saurabhparulekar24/HelMate/A02G_schematics-i/README.md

Review Assignment Due Date (https://classroom.github.com/a/yeGjPO4S)
# a02g-schematics-i

    * Team Number: 26
    * Team Name: Circuit Crusaders
    * Team Members: Binh Nguyen, Saurabh Parulekar
    * Description of hardware:
      1. HP Pavilion Windows Gaming laptop, 15" 8GB i5
      2. Apple M2 Pro - Macbook
    * Github Repository URL: https://github.com/ese5160/a02g-schematics-i-t26-circuit-crusaders

## 1 Component Creation
Component Location Updated BOM: [Circuit Crusaders BOM](https://github.com/ese5160/a02g-schematics-i-t26-circuit-crusaders/blob/main/A01G%20bom%20-%20Circuit%20Crusders.xlsx)

## 2 Schematic Capture
Altium Project Files: [Circuit Crusaders Project](https://upenn-eselabs.365.altium.com/designs/114505C5-8A92-40C3-9C26-AFBB1F629568)

## Github Repo Submission Resources

* [ESE5160 Example Repo Submission](https://github.com/ese5160/example-repository-submission)
* [Markdown Guide: Basic Syntax](https://www.markdownguide.org/basic-syntax/)
* [Adobe free video to gif converter](https://www.adobe.com/express/feature/video/convert/video-to-gif)
* [Curated list of example READMEs](https://github.com/matiassingers/awesome-readme)
* [VS Code](https://code.visualstudio.com/) is heavily recommended to develop code and handle Git commits
  * Code formatting and extension recommendation files come with this repository.
  * Ctrl+Shift+V will render the README.md (maybe not the images though)
