saurabhparulekar24/HelMate/A03G_schematics-ii/README.md

Review Assignment Due Date (https://classroom.github.com/a/Ba1hqn3X)
# a03g-schematics-ii

    * Team Number: 26
    * Team Name: Circuit Crusaders
    * Team Members: Saurabh Sandeep Parulekar, Binh Nguyen
    * Description of hardware: 
      1. HP Pavilion Windows Gaming laptop, 15" 8GB i5
      2. Apple M2 Pro - Macbook 
    * Github Repository URL: https://github.com/ese5160/a03g-schematics-ii-t26-circuit-crusaders

## 1 PCBA Bill of Materials (Altium)
[PCB Bill of Materials](https://upenn-eselabs.365.altium.com/designs/114505C5-8A92-40C3-9C26-AFBB1F629568#design)
## 2 Non PCBA Bill of Materials (Excel)
[Non PCB BOM](https://github.com/ese5160/a03g-schematics-ii-t26-circuit-crusaders/blob/main/A03G%20non%20pcba%20bom%20-%20Circuit%20Crusaders.xlsx)

## 3 Updated Schematic Capture
[Update Schematic Capture](https://upenn-eselabs.365.altium.com/designs/114505C5-8A92-40C3-9C26-AFBB1F629568#design)

## Github Repo Submission Resources

* [ESE5160 Example Repo Submission](https://github.com/ese5160/example-repository-submission)
* [Markdown Guide: Basic Syntax](https://www.markdownguide.org/basic-syntax/)
* [Adobe free video to gif converter](https://www.adobe.com/express/feature/video/convert/video-to-gif)
* [Curated list of example READMEs](https://github.com/matiassingers/awesome-readme)
* [VS Code](https://code.visualstudio.com/) is heavily recommended to develop code and handle Git commits
  * Code formatting and extension recommendation files come with this repository.
  * Ctrl+Shift+V will render the README.md (maybe not the images though)
