saurabhparulekar24/HelMate/A05G_release/README.md

Review Assignment Due Date (https://classroom.github.com/a/8iX7Ein-)
# a05g-release

    * Team Number: 26
    * Team Name: Circuit Crusaders
    * Team Members: Saurabh Parulekar, Binh Nguyen
    * Description of hardware: (embedded hardware, laptop, etc):
       + 1. HP Pavilion Windows Gaming laptop, 15" 8GB i5
       + 2. Apple M2 Pro - Macbook  
    * Github Repository URL: https://github.com/ese5160/a05g-release-t26-circuit-crusaders

## 1 PCB Finishing Touches
[Project Link](https://upenn-eselabs.365.altium.com/designs/114505C5-8A92-40C3-9C26-AFBB1F629568#design)

## 2 PCB Documentation
[Project Link](https://upenn-eselabs.365.altium.com/designs/114505C5-8A92-40C3-9C26-AFBB1F629568#design)

## 3 PCB Manufacturing Release
[Project Link](https://upenn-eselabs.365.altium.com/designs/114505C5-8A92-40C3-9C26-AFBB1F629568#design)

## 4 3D Printed PCBA
Proof that we submitted 3D printing

## Github Repo Submission Resources

* [ESE5160 Example Repo Submission](https://github.com/ese5160/example-repository-submission)
* [Markdown Guide: Basic Syntax](https://www.markdownguide.org/basic-syntax/)
* [Adobe free video to gif converter](https://www.adobe.com/express/feature/video/convert/video-to-gif)
* [Curated list of example READMEs](https://github.com/matiassingers/awesome-readme)
* [VS Code](https://code.visualstudio.com/) is heavily recommended to develop code and handle Git commits
  * Code formatting and extension recommendation files come with this repository.
  * Ctrl+Shift+V will render the README.md (maybe not the images though)
