saurabhparulekar24/HelMate/A00G_devices-designs-diagrams/Design/Block_Diagrams/detailed_block_diagram.png

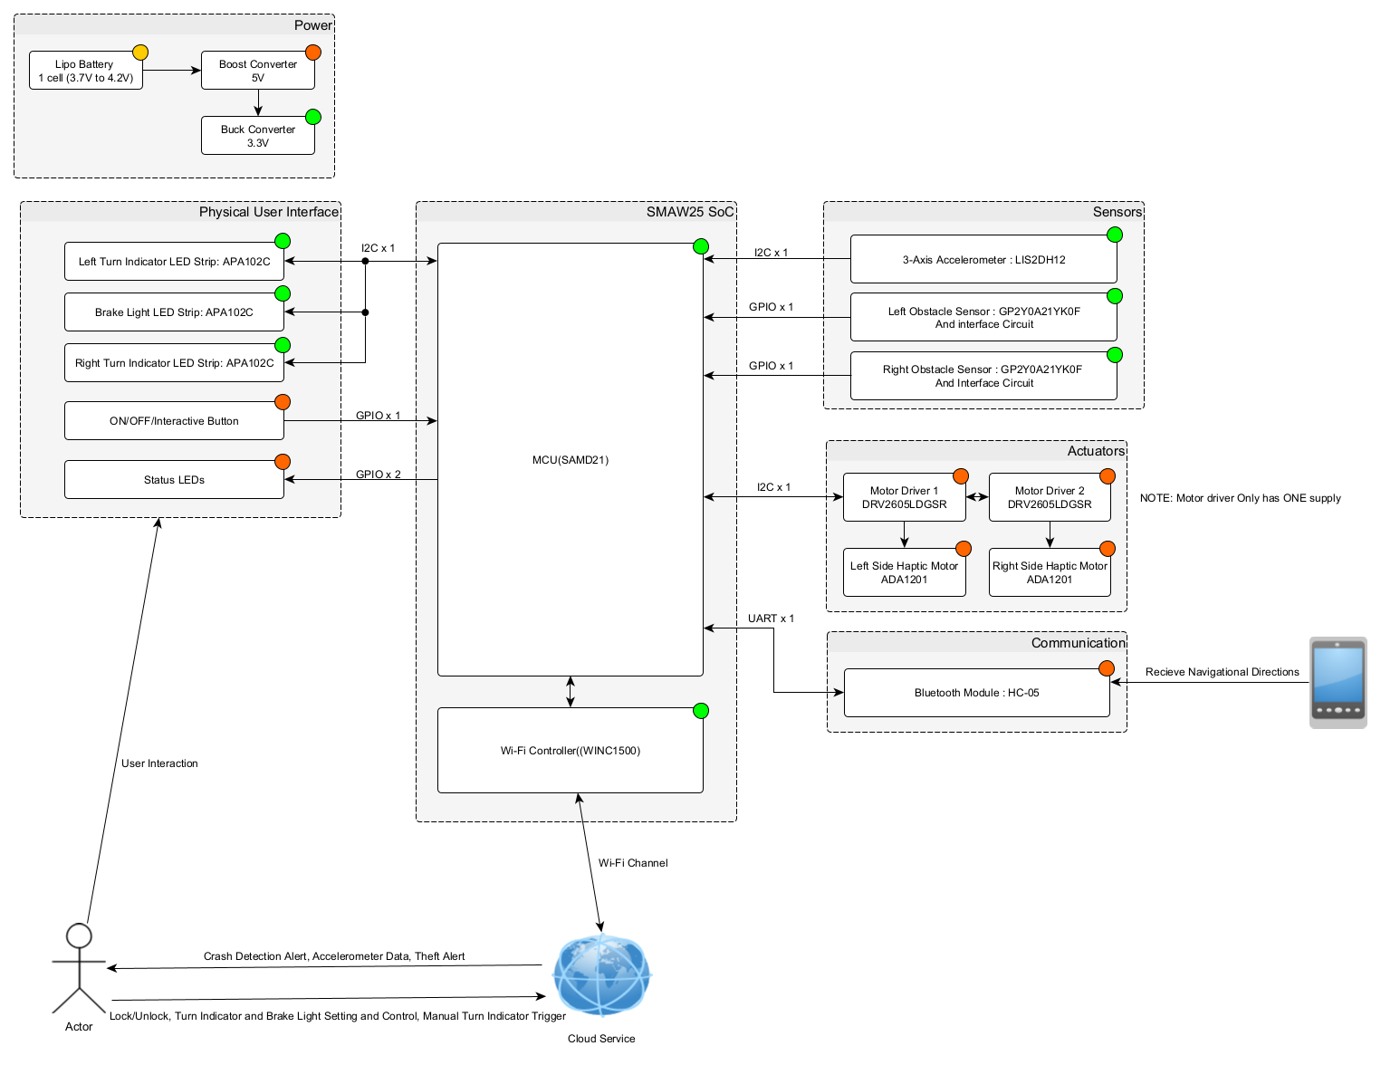
A00G_devices-designs-diagrams/Design/Block_Diagrams/detailed_block_diagram.png
