saurabhparulekar24/HelMate/A01G_components-pins-power/images/power_architecture.png

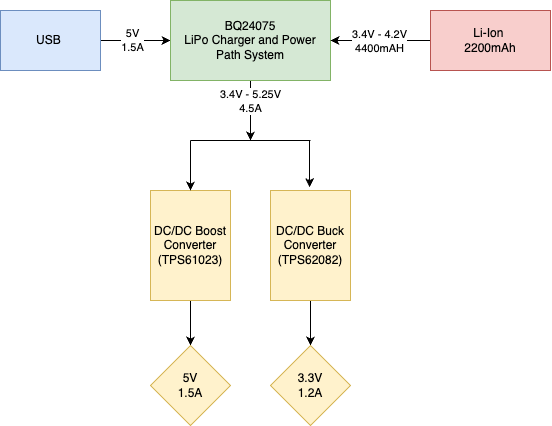
A01G_components-pins-power/images/power_architecture.png
