saurabhparulekar24/HelMate/A01G_components-pins-power/images/power_requirements.jpeg

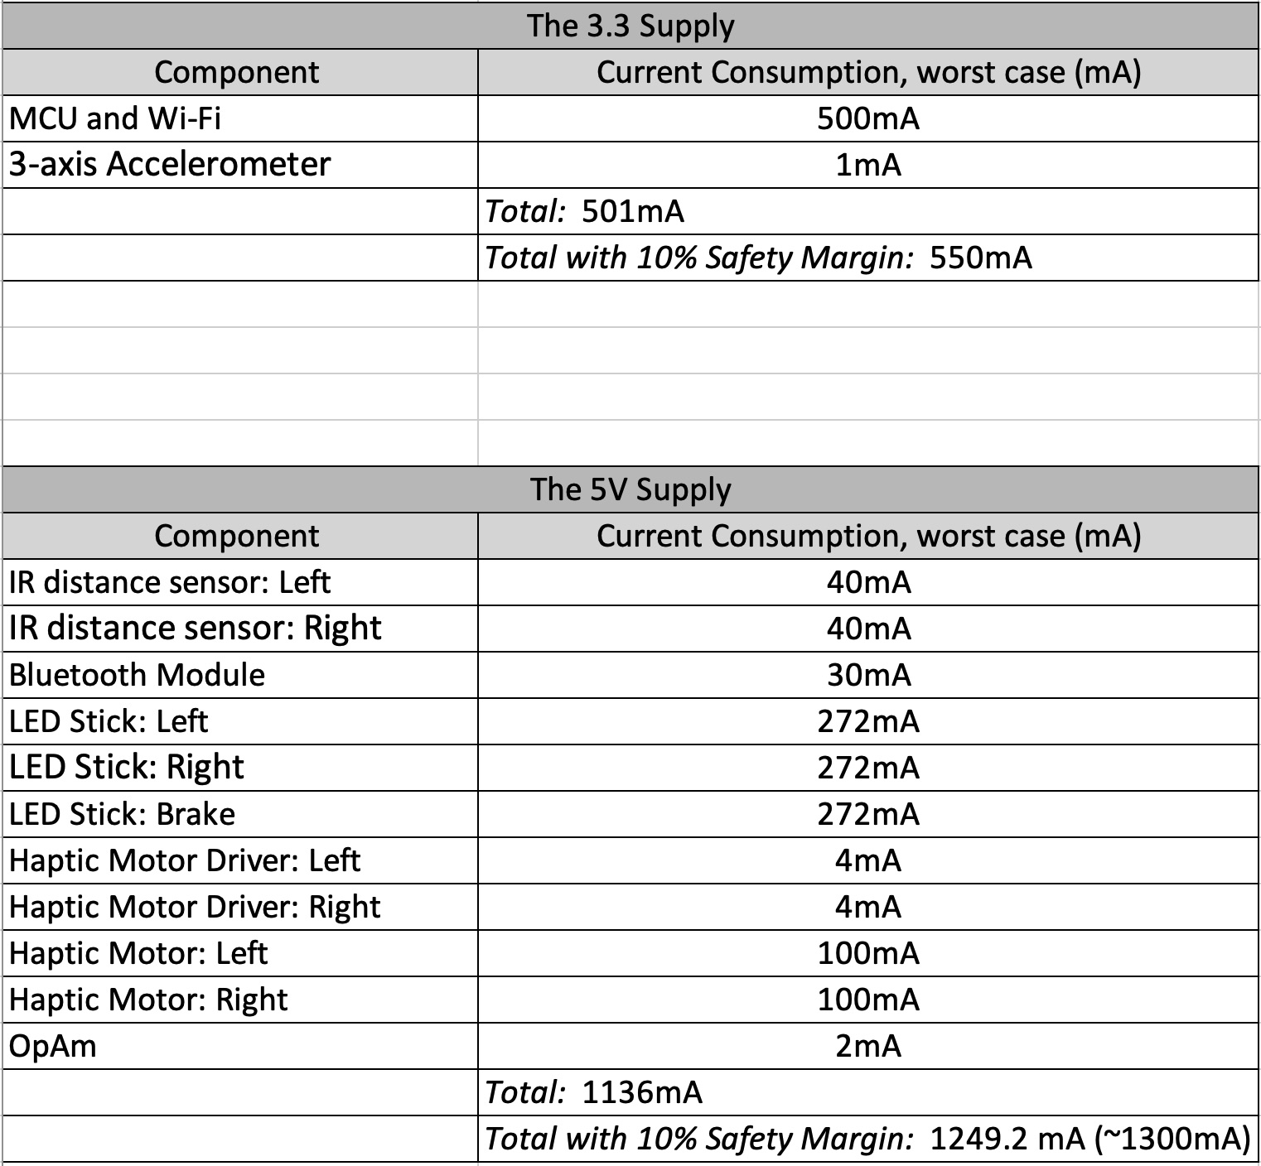
A01G_components-pins-power/images/power_requirements.jpeg
