saurabhparulekar24/HelMate/A04G_layout/image/trace_width.png

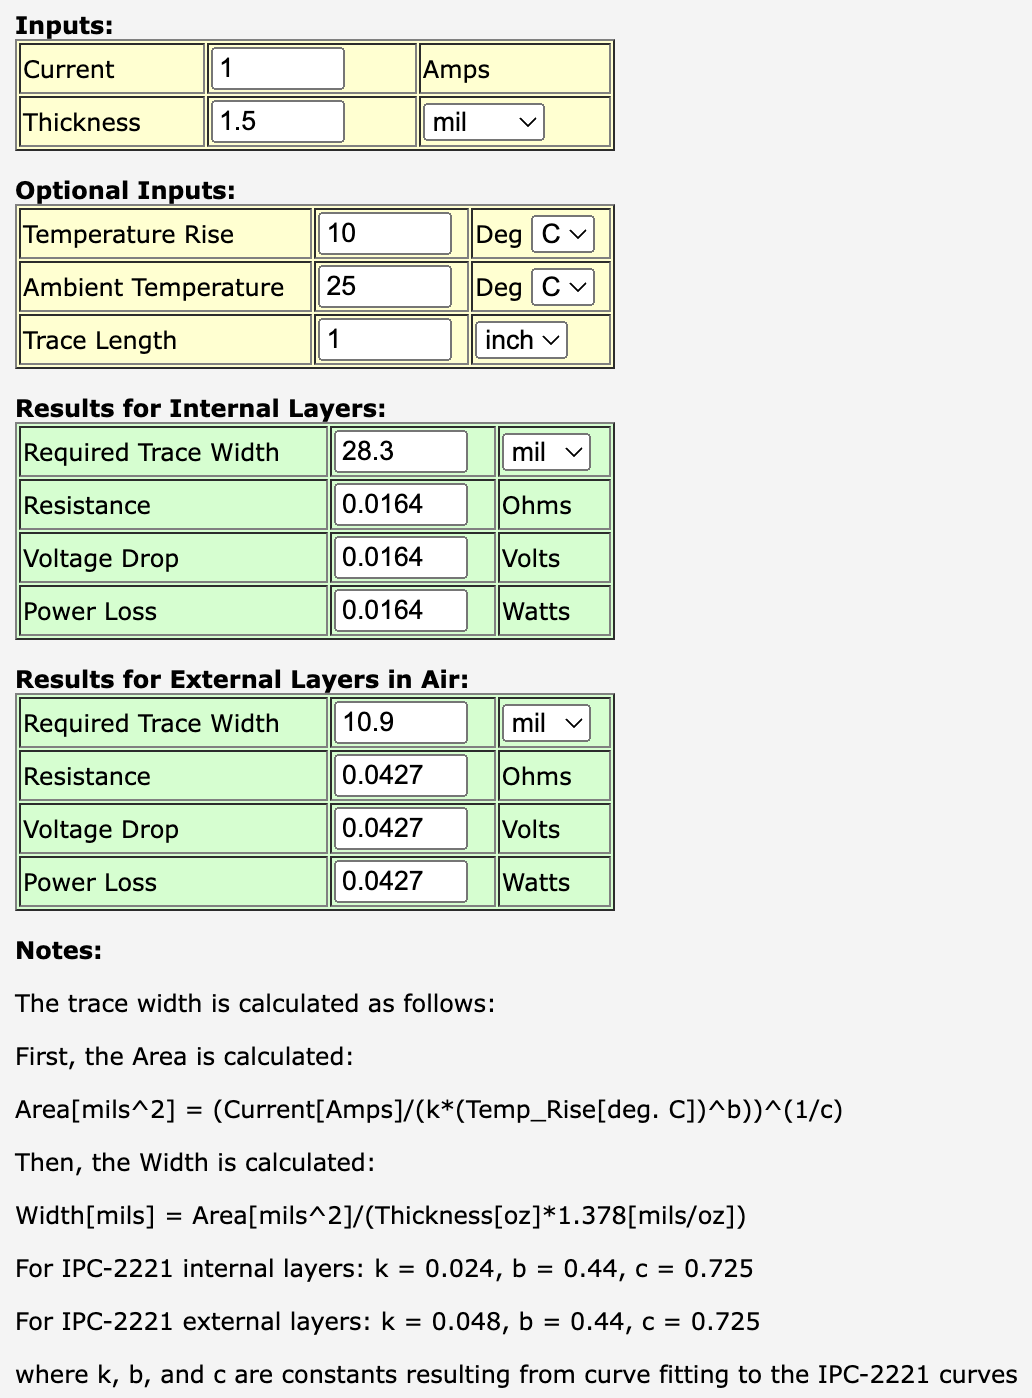
A04G_layout/image/trace_width.png
