saurabhparulekar24/HelMate/A05G_release/image/Email.jpeg

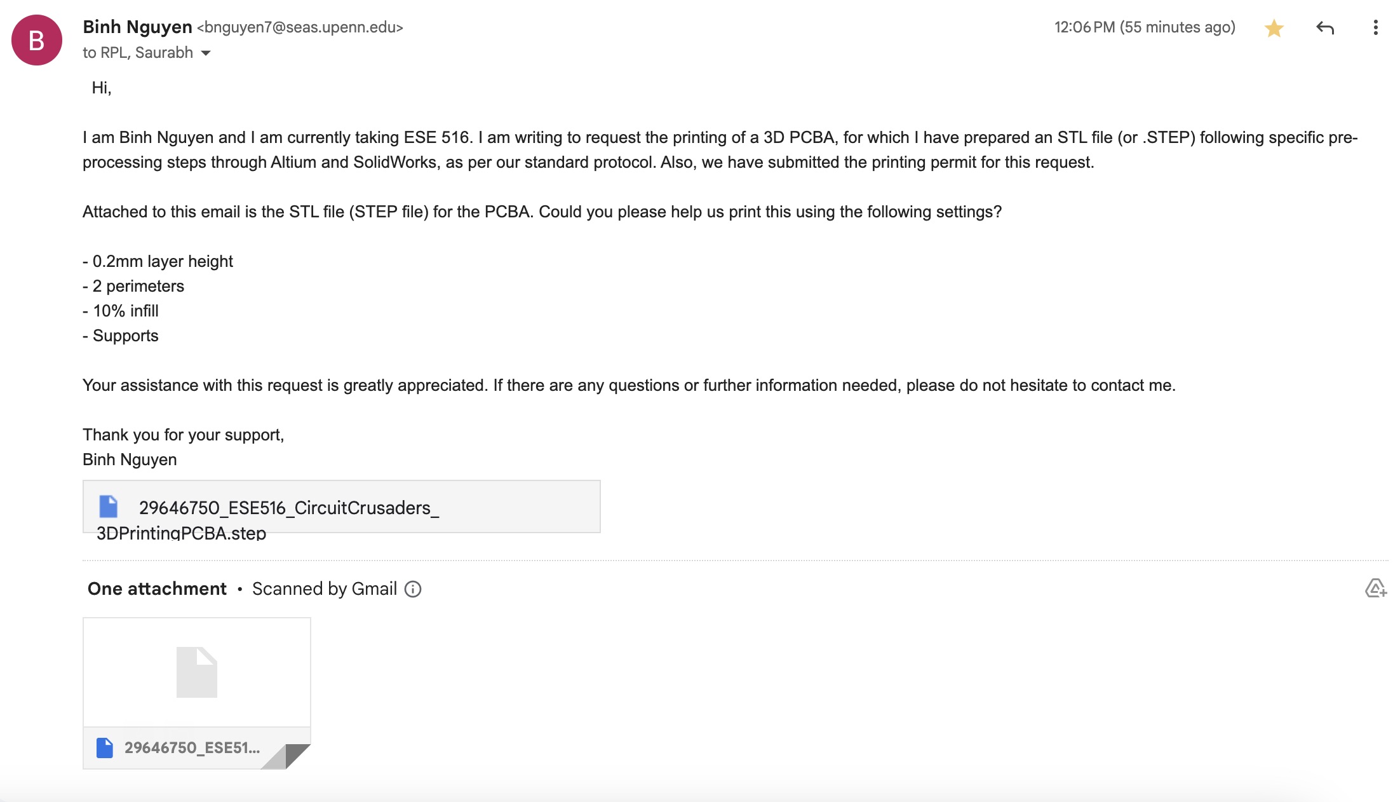
A05G_release/image/Email.jpeg
