saurabhparulekar24/HelMate/A05G_release/image/Form.jpeg

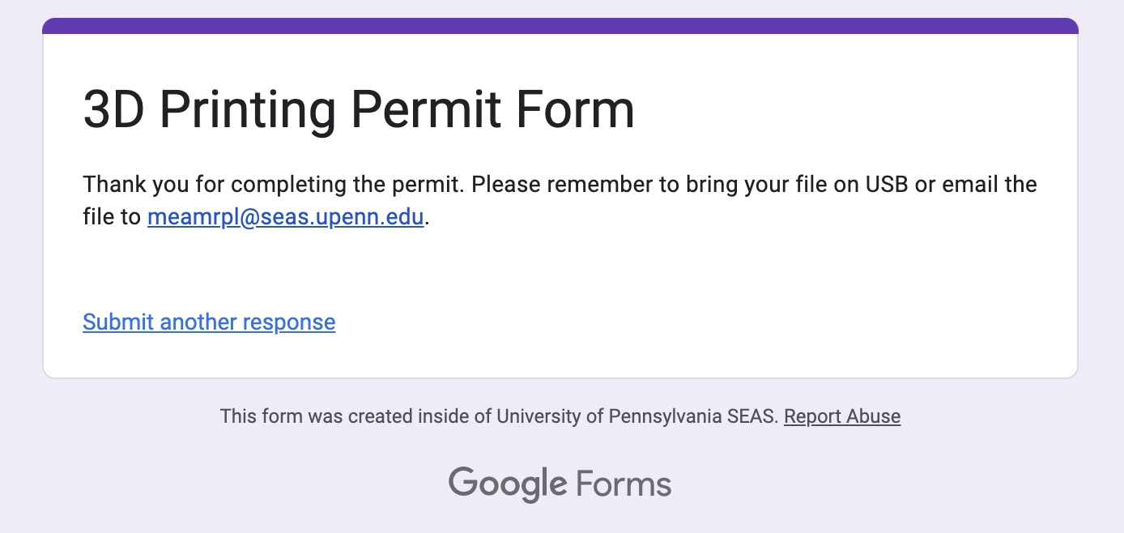
A05G_release/image/Form.jpeg
