saurabhparulekar24/HelMate/A06P_freertos-i2c/images/LED_End_Stack.png

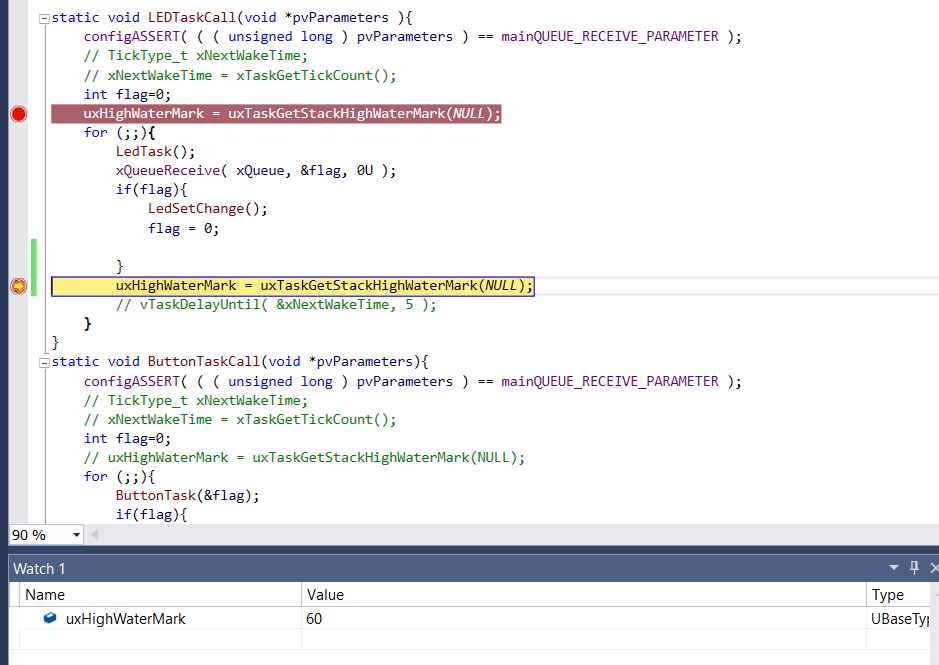
A06P_freertos-i2c/images/LED_End_Stack.png
