saurabhparulekar24/HelMate/A06P_freertos-i2c/images/LED_Start_Stack.png

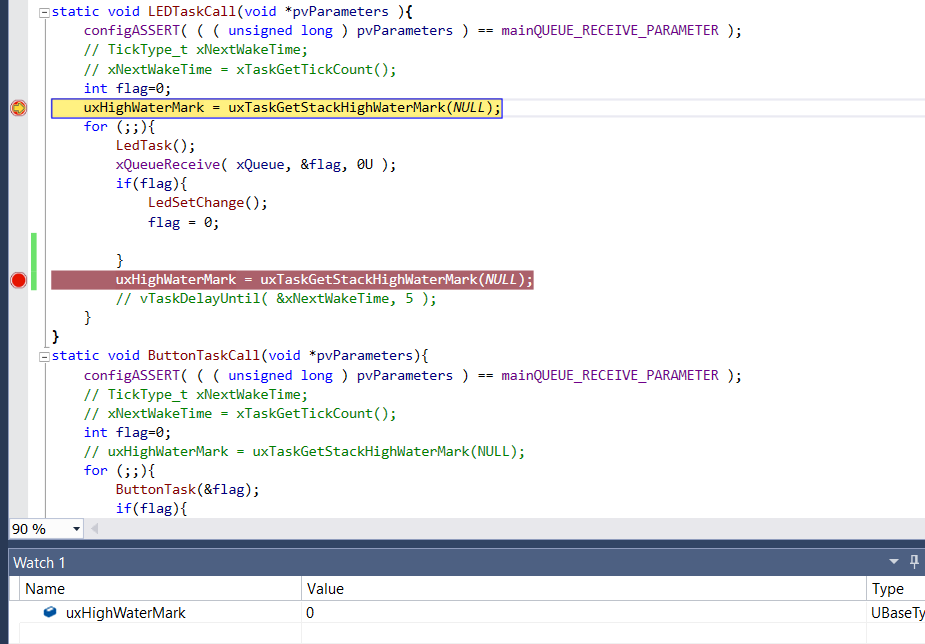
A06P_freertos-i2c/images/LED_Start_Stack.png
