saurabhparulekar24/HelMate/A06P_freertos-i2c/images/WINC1500Update.png

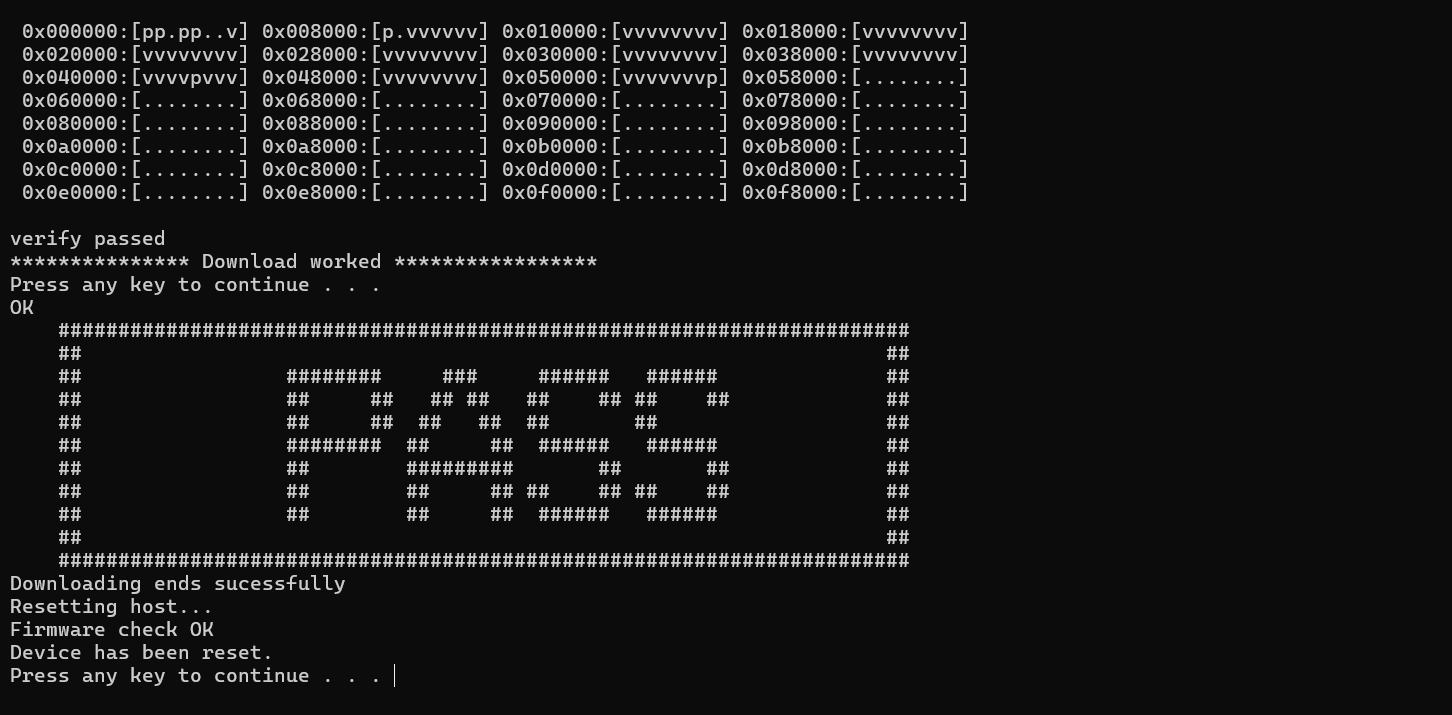
A06P_freertos-i2c/images/WINC1500Update.png
