saurabhparulekar24/HelMate/A07G_exploring-the-cli/Images and Captures/COM11  (EDBG Virtual COM Port (COM11)) 2024-03-20 13-27-54.gif

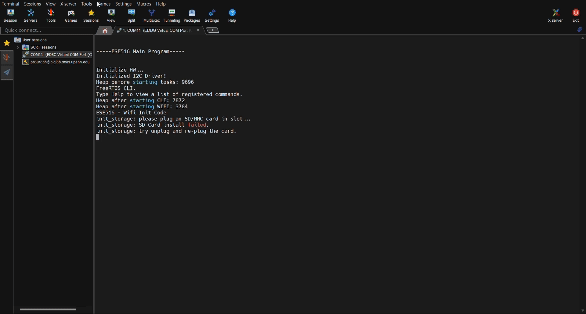
A07G_exploring-the-cli/Images and Captures/COM11 (EDBG Virtual COM Port (COM11)) 2024-03-20 13-27-54.gif
