saurabhparulekar24/HelMate/A07G_exploring-the-cli/Images and Captures/percipio.png

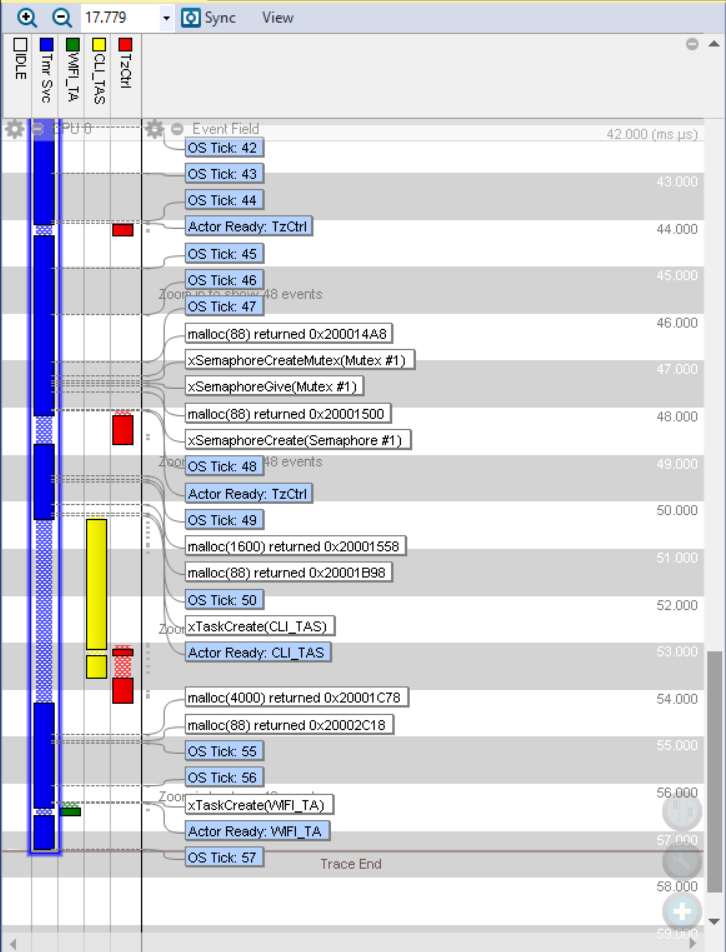
A07G_exploring-the-cli/Images and Captures/percipio.png
