saurabhparulekar24/HelMate/A07G_exploring-the-cli/Images and Captures/Q7.jpg

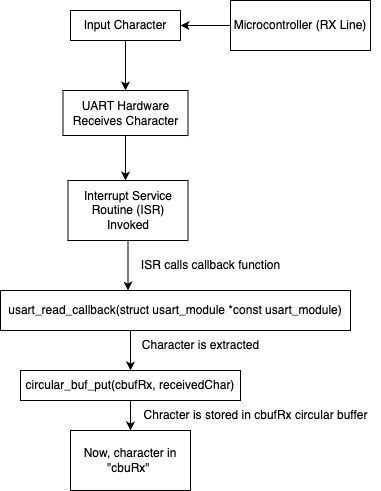
A07G_exploring-the-cli/Images and Captures/Q7.jpg
