saurabhparulekar24/HelMate/A07G_exploring-the-cli/Images and Captures/Q8.jpg

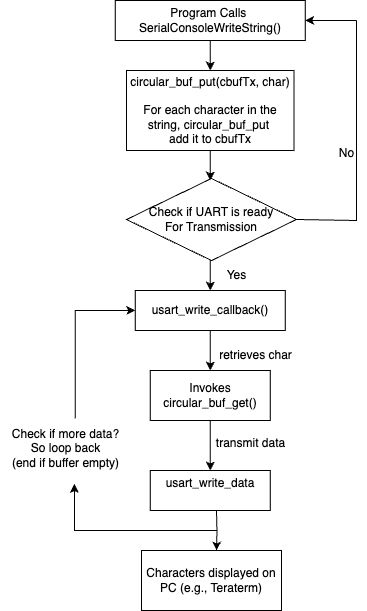
A07G_exploring-the-cli/Images and Captures/Q8.jpg
