saurabhparulekar24/HelMate/A07G_exploring-the-cli/Images and Captures/ResetfromCLI.png

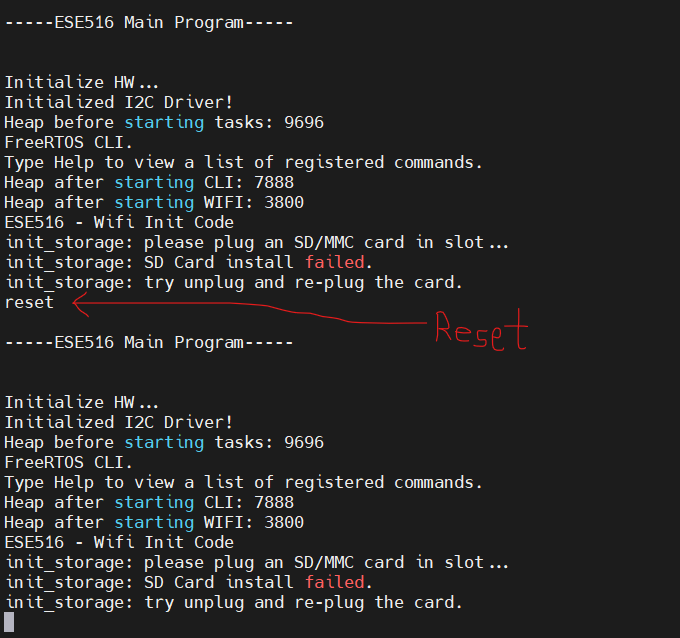
A07G_exploring-the-cli/Images and Captures/ResetfromCLI.png
