saurabhparulekar24/HelMate/A07G_exploring-the-cli/Images and Captures/USART_Pins.png

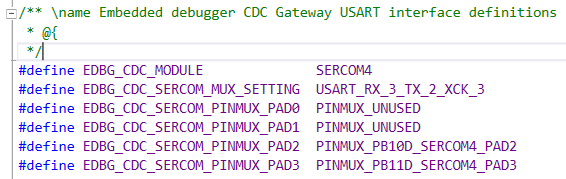
A07G_exploring-the-cli/Images and Captures/USART_Pins.png
