saurabhparulekar24/HelMate/A08G_comm-protocols/Images and Captures/Daisychain.drawio.png

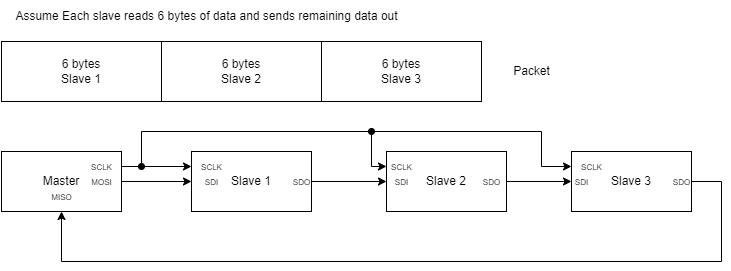
A08G_comm-protocols/Images and Captures/Daisychain.drawio.png
