saurabhparulekar24/HelMate/A08G_comm-protocols/Images and Captures/I2C_data.png

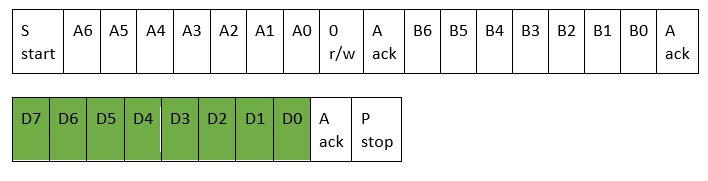
A08G_comm-protocols/Images and Captures/I2C_data.png
