saurabhparulekar24/HelMate/A08G_comm-protocols/Images and Captures/IMU_SS.png

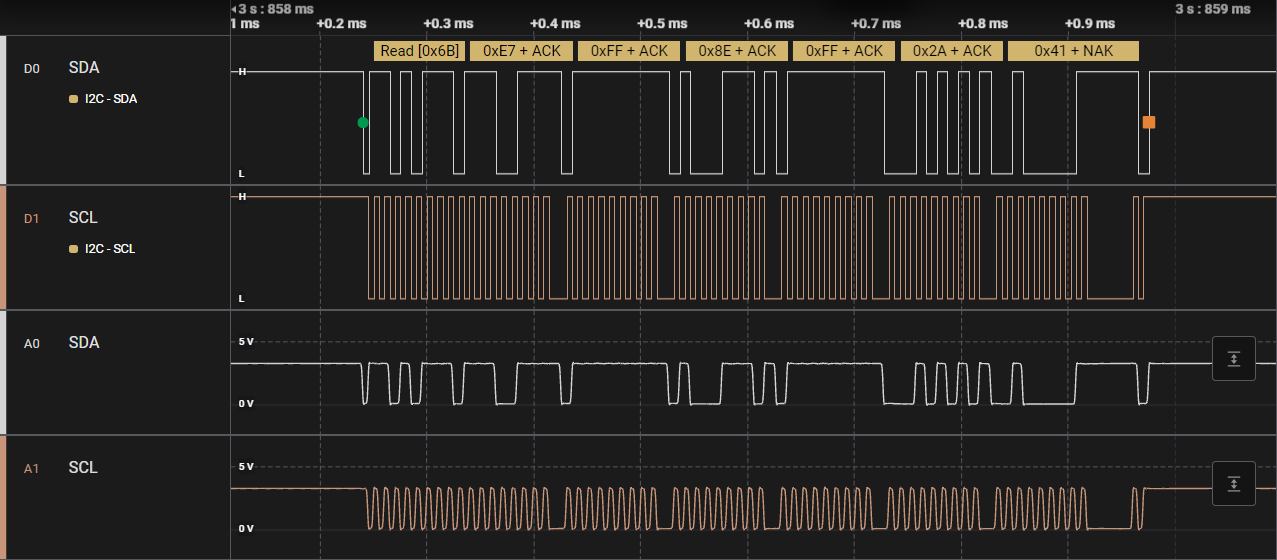
A08G_comm-protocols/Images and Captures/IMU_SS.png
