saurabhparulekar24/HelMate/A08G_comm-protocols/Images and Captures/SPI_S_to_V.png

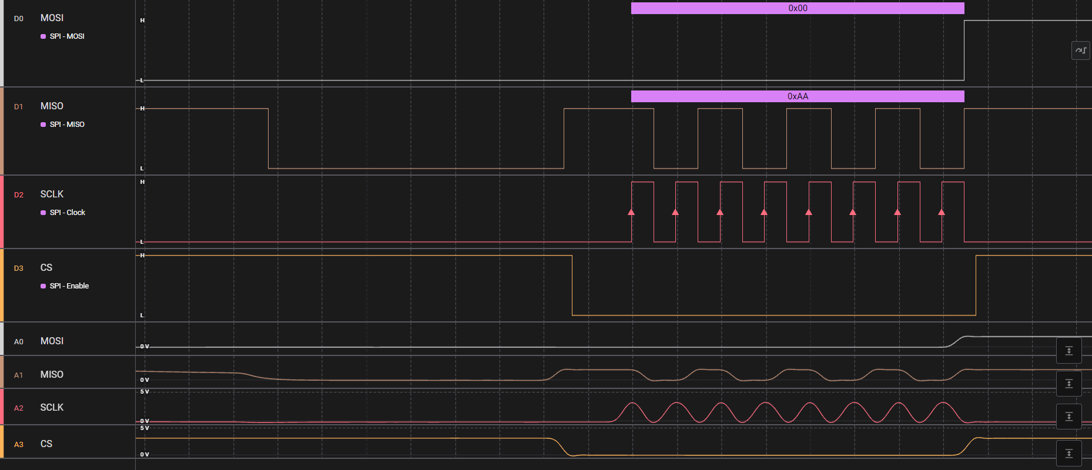
A08G_comm-protocols/Images and Captures/SPI_S_to_V.png
