saurabhparulekar24/HelMate/A08G_comm-protocols/Images and Captures/UART_V_to_S.png

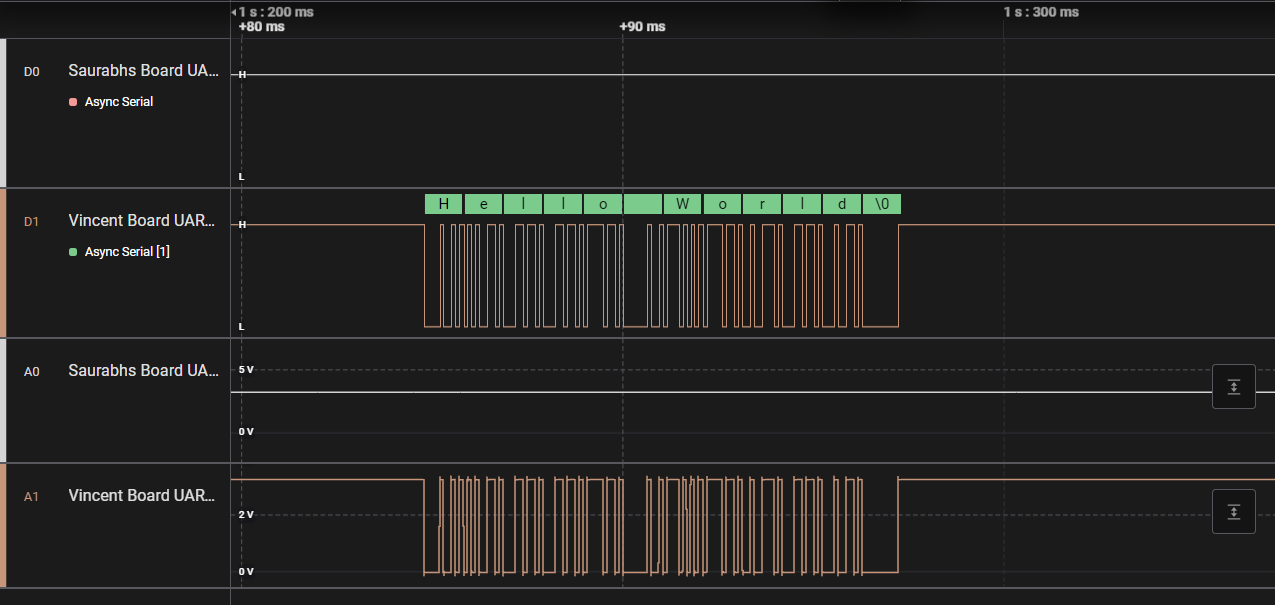
A08G_comm-protocols/Images and Captures/UART_V_to_S.png
