saurabhparulekar24/HelMate/A09G_the-bootloader-waltz/images and Captures/BlockDiagramI2C.drawio (1).png

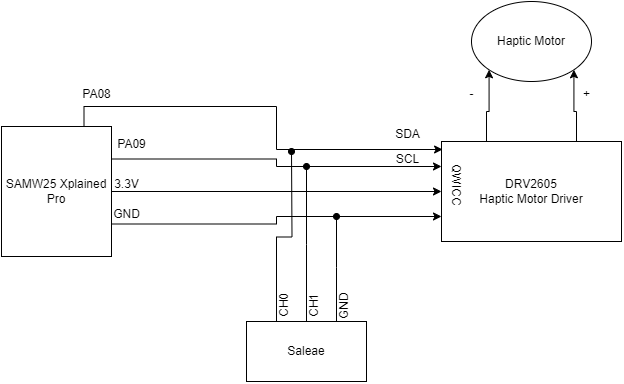
A09G_the-bootloader-waltz/images and Captures/BlockDiagramI2C.drawio (1).png
