saurabhparulekar24/HelMate/A09G_the-bootloader-waltz/images and Captures/BootLoader_FlowChart.png

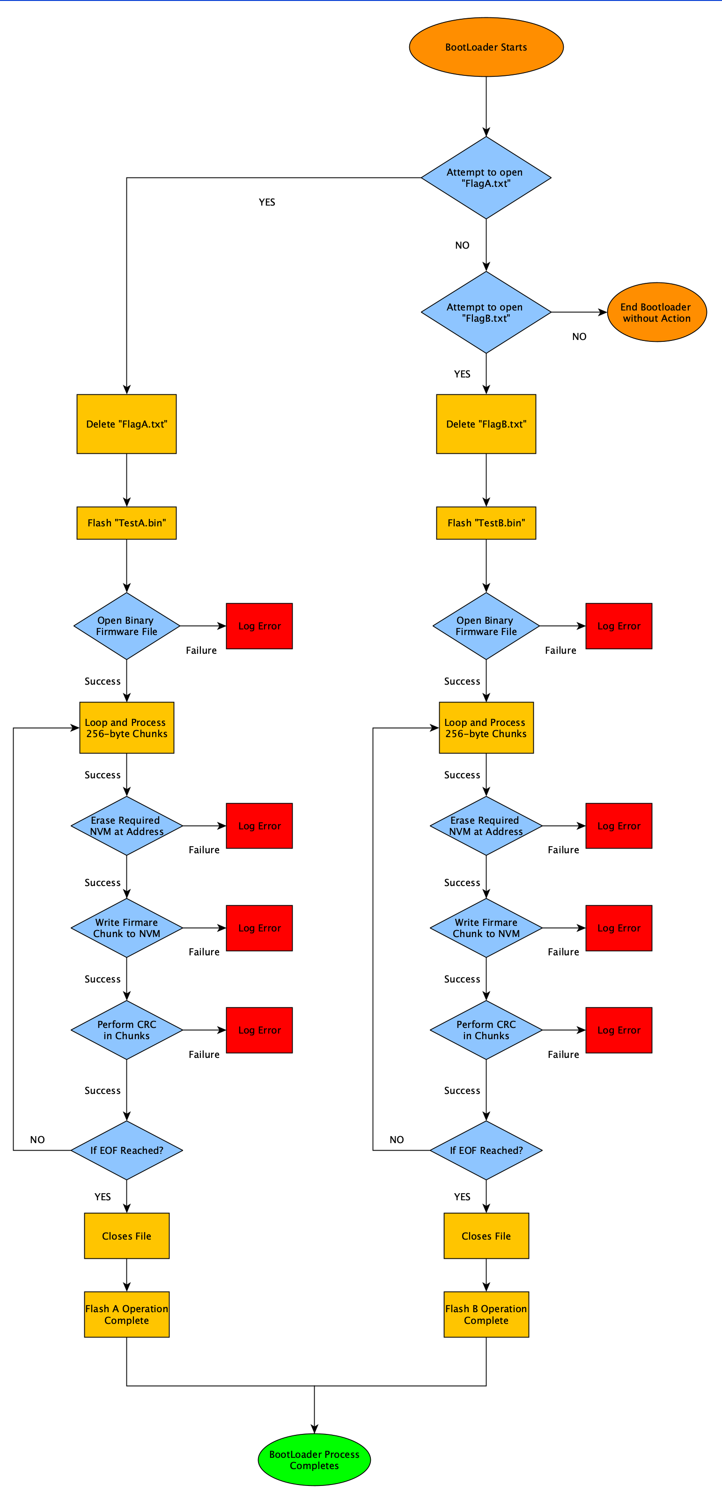
A09G_the-bootloader-waltz/images and Captures/BootLoader_FlowChart.png
