saurabhparulekar24/HelMate/A09G_the-bootloader-waltz/images and Captures/haptic_i2c_capture2 2.png

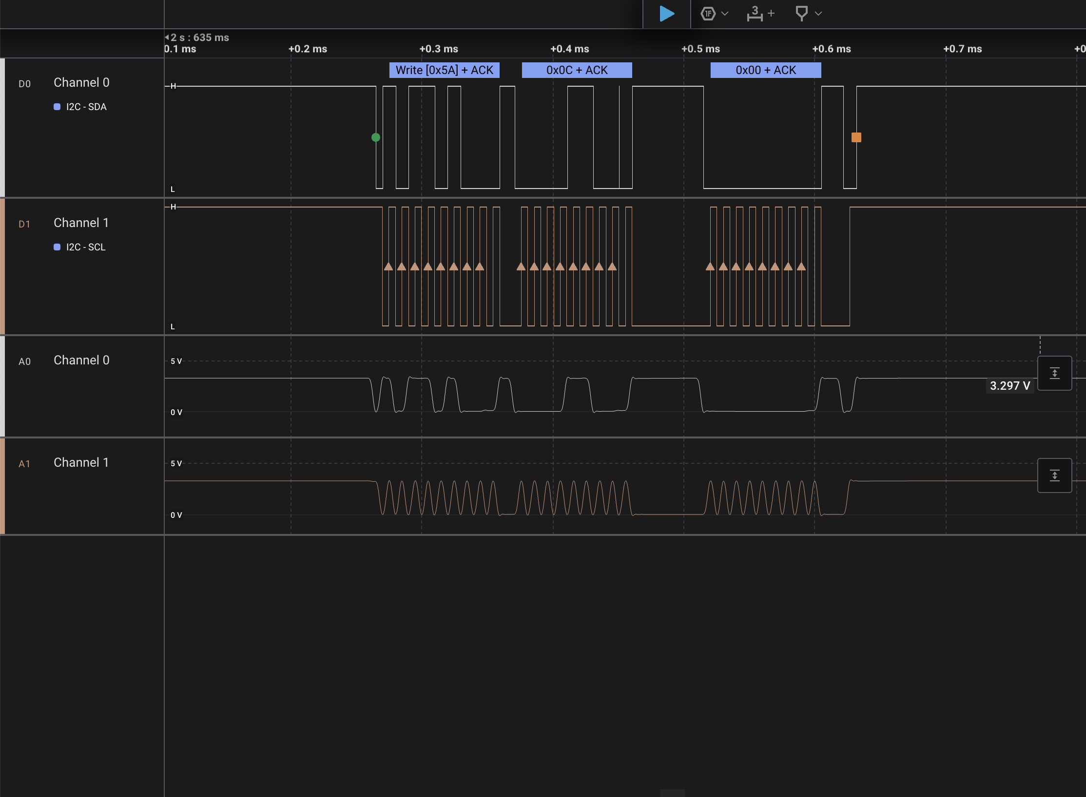
A09G_the-bootloader-waltz/images and Captures/haptic_i2c_capture2 2.png
