saurabhparulekar24/HelMate/A09G_the-bootloader-waltz/images and Captures/Saleae_Capture_SS.jpg

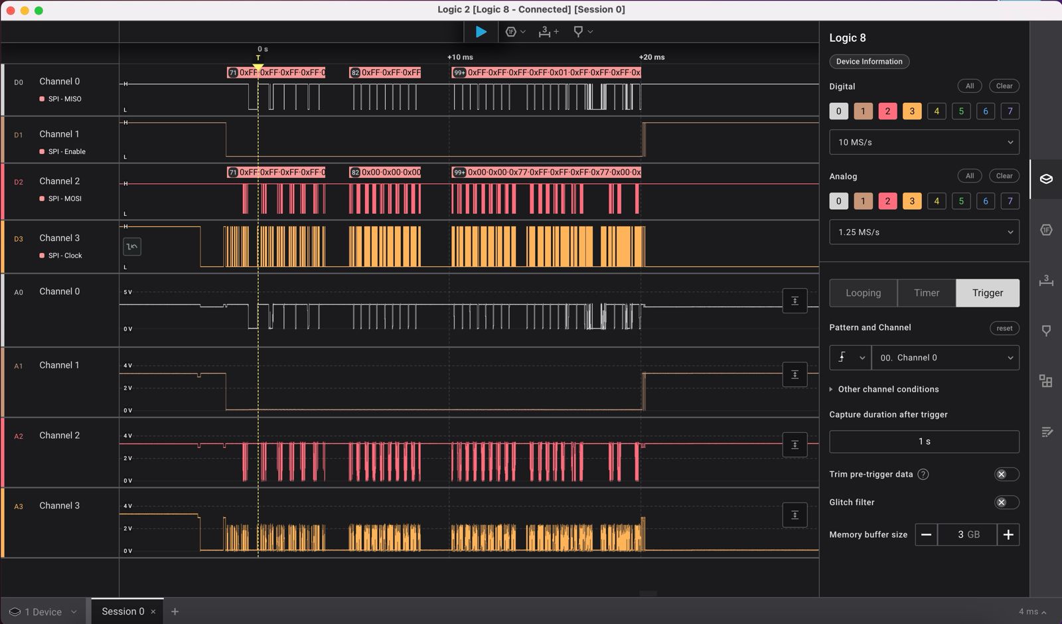
A09G_the-bootloader-waltz/images and Captures/Saleae_Capture_SS.jpg
