saurabhparulekar24/HelMate/A10G_cloud/images/part3_backend.png

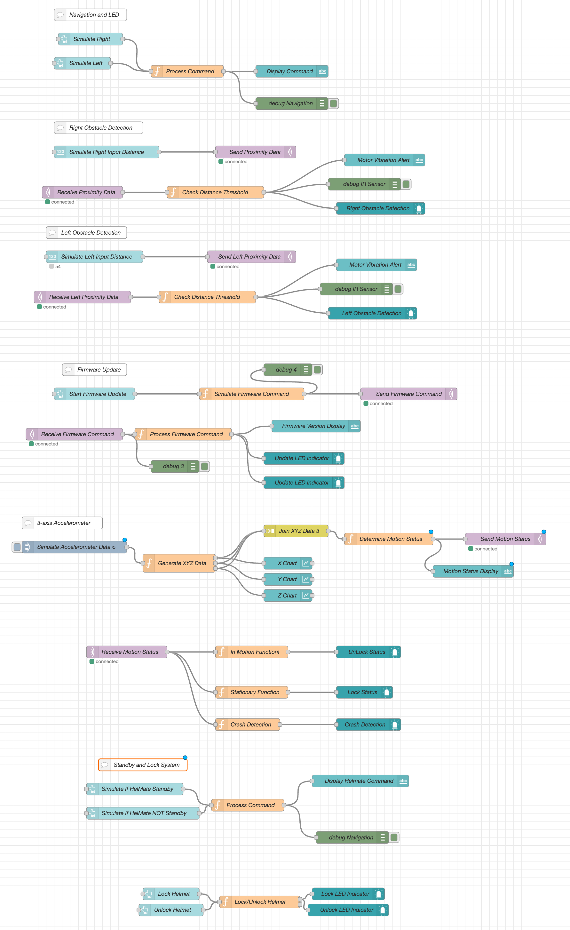
A10G_cloud/images/part3_backend.png
