saurabhparulekar24/HelMate/A10G_cloud/images/part3_frontend.png

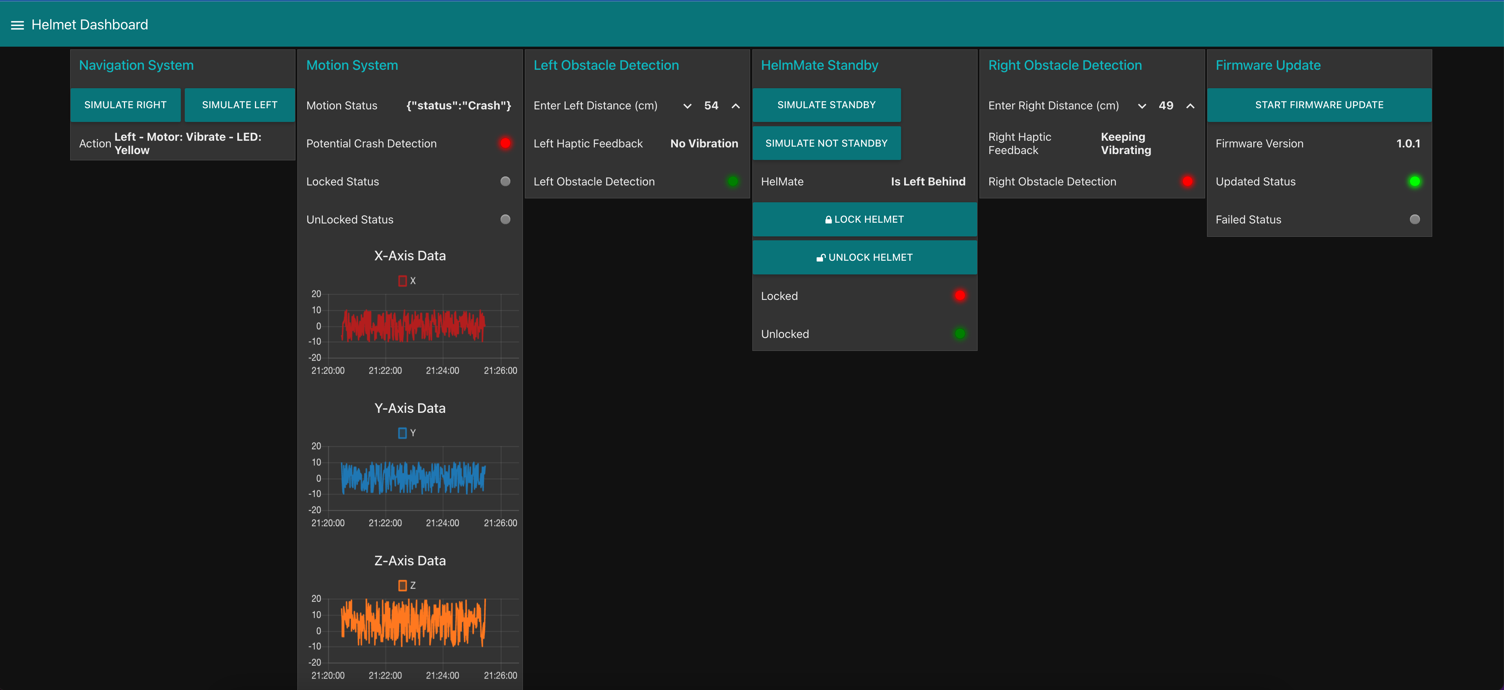
A10G_cloud/images/part3_frontend.png
