saurabhparulekar24/HelMate/A10G_cloud/images/percipio.png

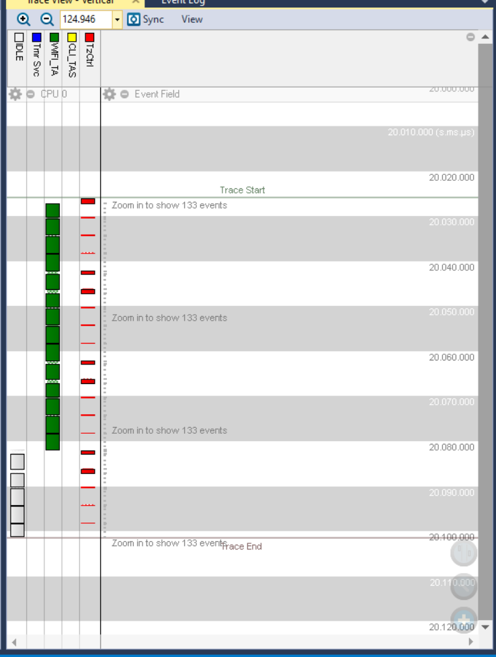
A10G_cloud/images/percipio.png
