saurabhparulekar24/HelMate/A12G_firmware-drivers/images/Accelerometer.png

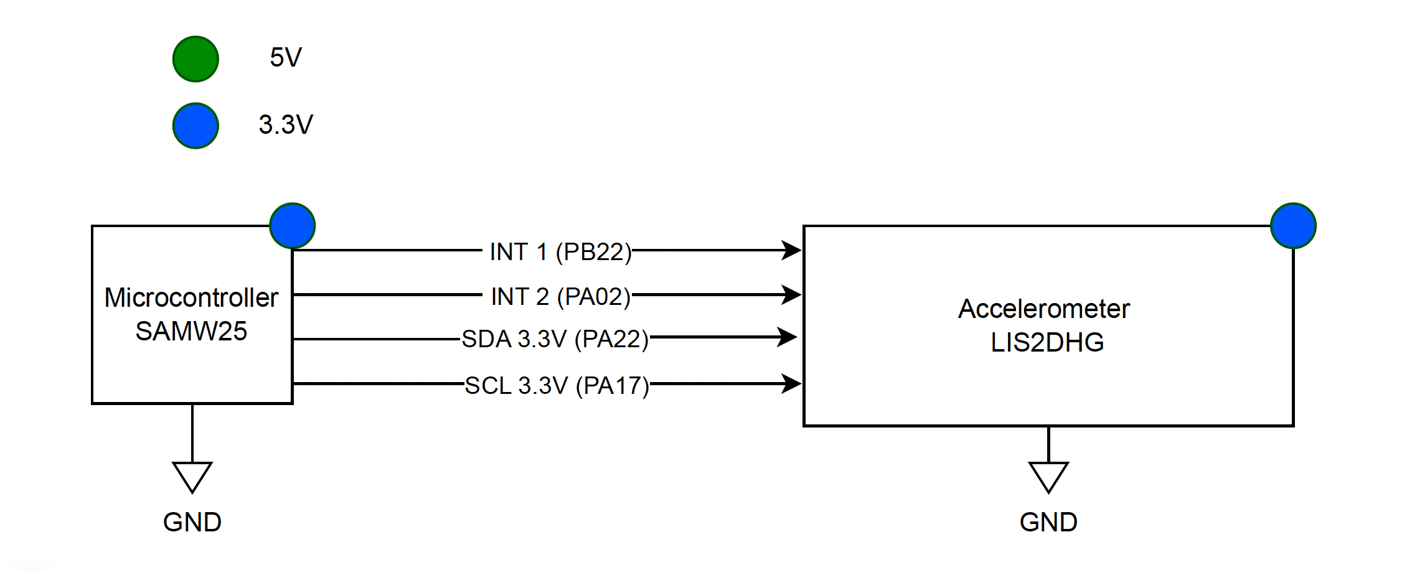
A12G_firmware-drivers/images/Accelerometer.png
