saurabhparulekar24/HelMate/A12G_firmware-drivers/images/Haptic_BD.drawio.png

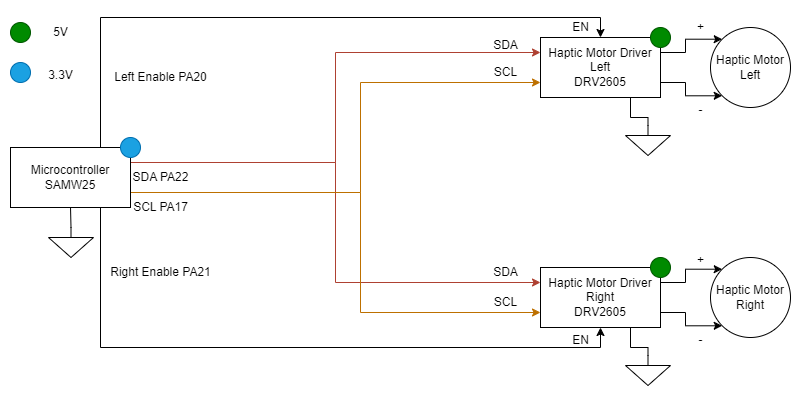
A12G_firmware-drivers/images/Haptic_BD.drawio.png
