saurabhparulekar24/HelMate/A12G_firmware-drivers/images/IR_Sensor.drawio.png

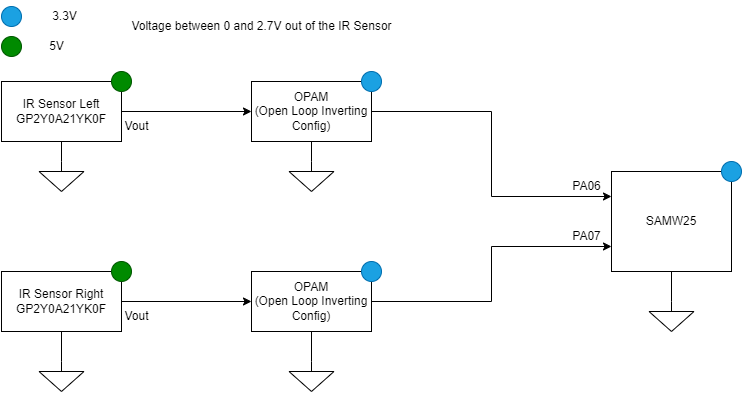
A12G_firmware-drivers/images/IR_Sensor.drawio.png
