saurabhparulekar24/HelMate/A12G_firmware-drivers/images/LED_Hardware.png

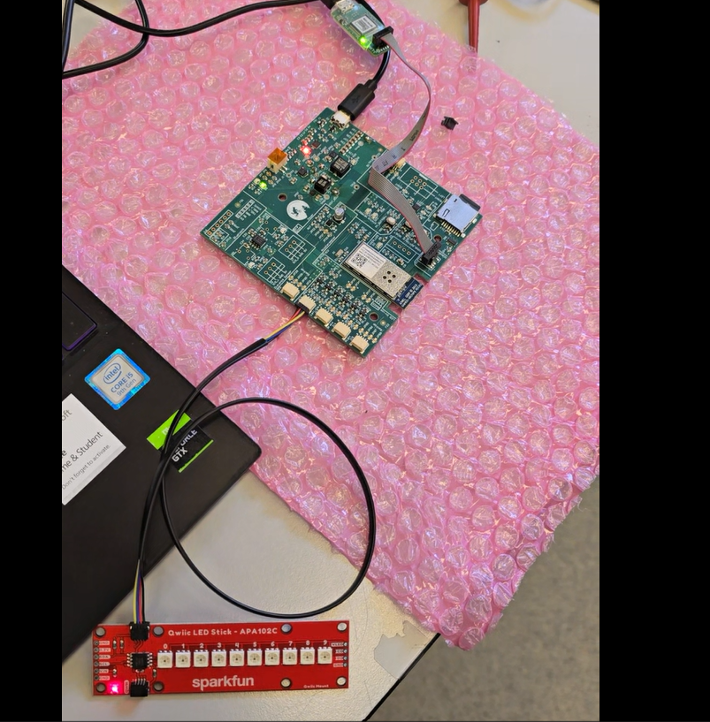
A12G_firmware-drivers/images/LED_Hardware.png
