saurabhparulekar24/HelMate/A12G_firmware-drivers/images/LED_Strip.png

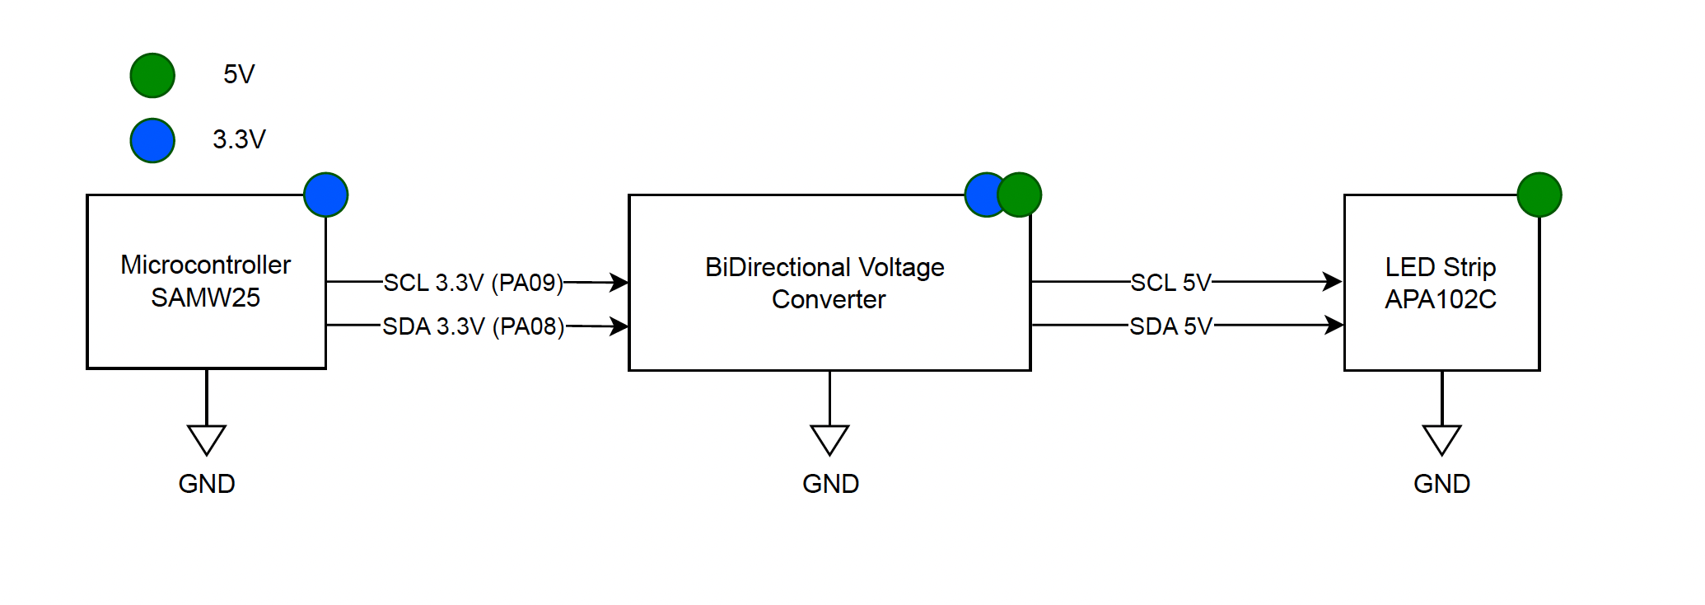
A12G_firmware-drivers/images/LED_Strip.png
