saurabhparulekar24/HelMate/A14G_final-submission/images/back_view_helmat_2.jpg

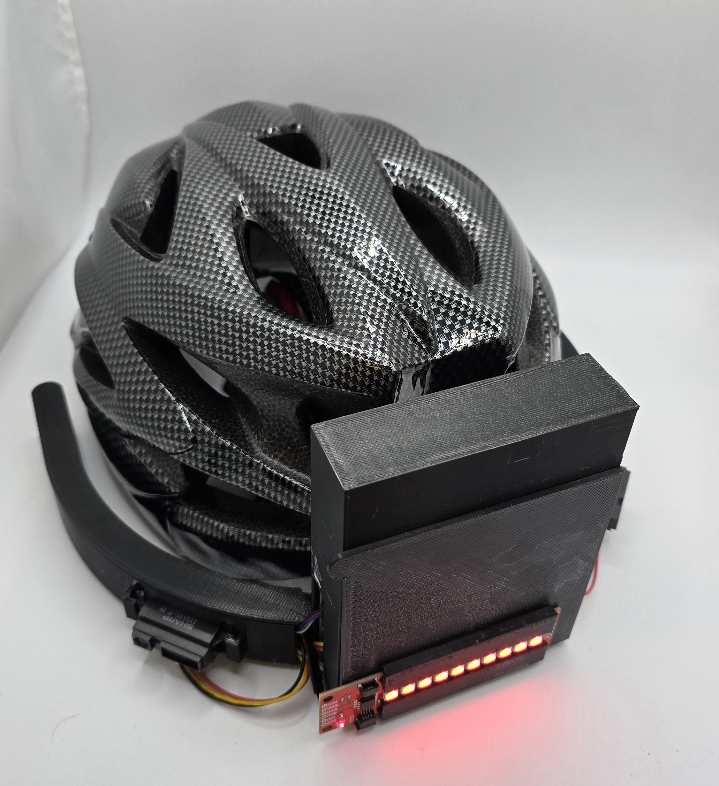
A14G_final-submission/images/back_view_helmat_2.jpg
