saurabhparulekar24/HelMate/A14G_final-submission/images/back_view_helmat_3.jpg

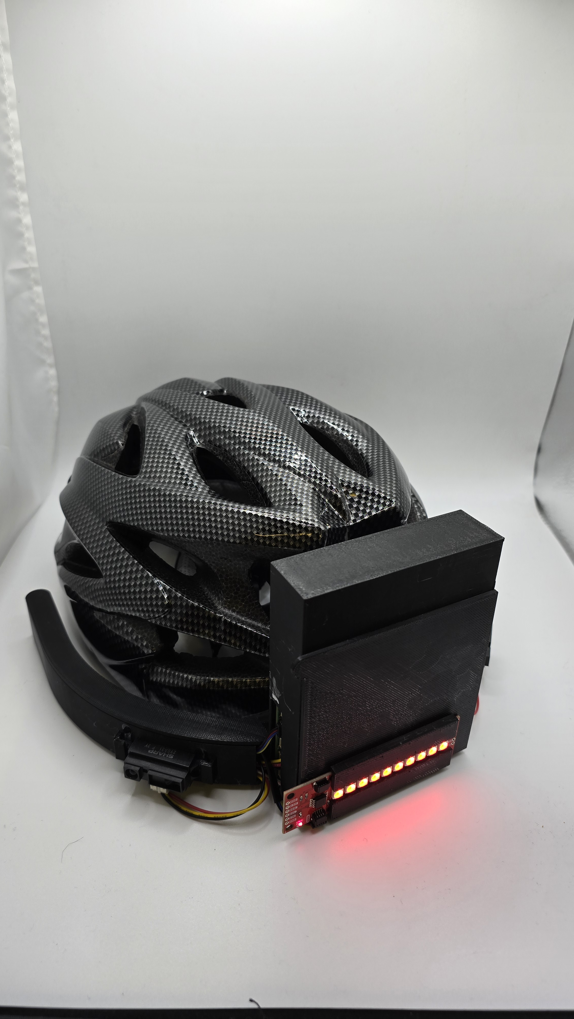
A14G_final-submission/images/back_view_helmat_3.jpg
