saurabhparulekar24/HelMate/A14G_final-submission/images/side_view_with_helmate.jpg

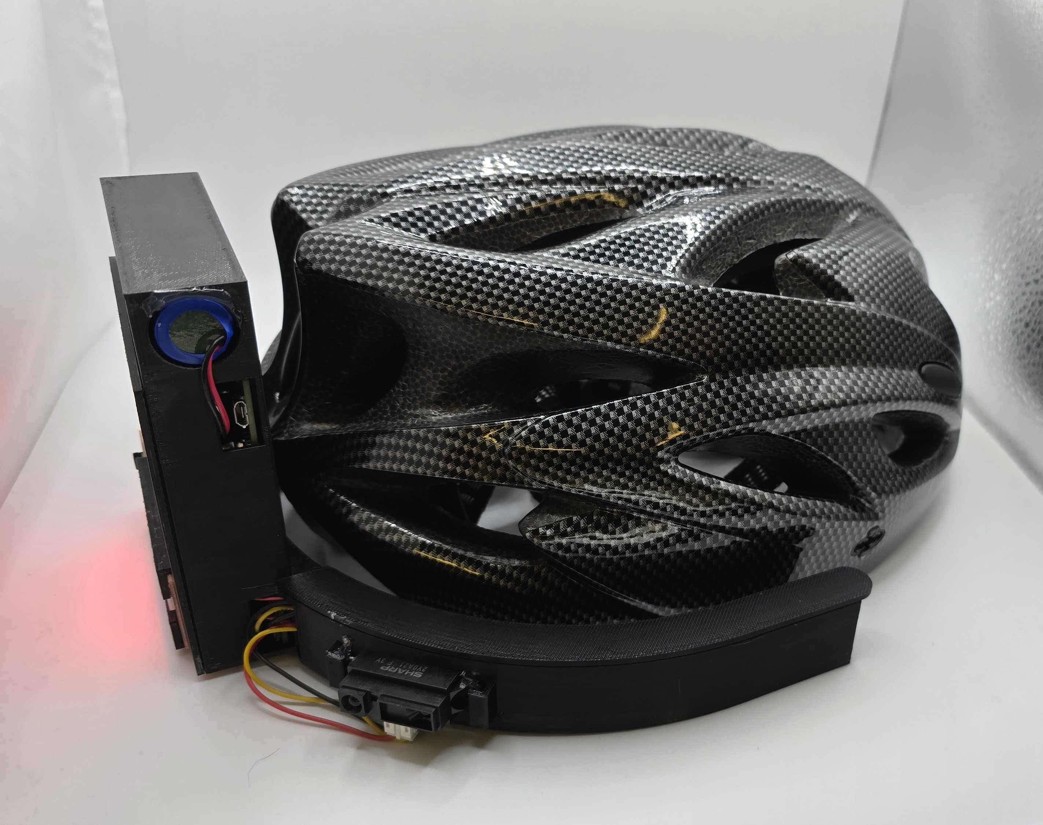
A14G_final-submission/images/side_view_with_helmate.jpg
