saurabhparulekar24/HelMate/A01G_components-pins-power/A01G bom - Circuit Crusders.xlsx

Sheet: Template (For you to use)
Team Number | 26
Team Name | Circuit Crusaders
Team Member # 1 | Vincent Nyugen
Team Member # 2 | Saurabh Parulekar
Row of totals |  |  |  |  |  |  |  |  |  | 1050.6 | 1636 | 32.3 | $89.42 | $31.20
Component | Digital Component Location (For A02 assignment) | Manufacturer | Manufacturer part number (MPN) | Distributor | Distributor Part Number | Mounting Type | Interface to MCU | Voltage (Min) | Voltage (Max) | Current Consumption, typical case (mA) | Current Consumption, worst case (mA) | Quiescent current (mA) | Cost QTY 1 | Cost QTY 1K | Dev Board Link (Required) | Dev Board Price | Comments
MCU and Wi-Fi | UPenn ESE Vault | Microchip | ATSAMW25H18-MR210PB1952 | DigiKey | ATSAMW25H18-MR210PB1952-ND | SMT | N/A | 2.7V | 4.3V | 200 | 500 | 1 | $12.05 | $10.92 | https://www.digikey.com/en/products/detail/microchip-technology/ATSAMW25-XPRO/5235960 | $41.04 | ESE5160 MCU and WiFi SoC
3-axis Accelerometer | Manually made connector in SchLib and PcbLib | ST | LIS2DH12TR | DigiKey | 497-14851-2-ND | SMT | I2C | 1.7V | 3.6V | 1 | 1 | N/A | $2.30 | $1.02 | https://www.digikey.com/en/products/detail/stmicroelectronics/STEVAL-MKI151V1/7313548?gad_source=1 | $19.95 | Ulta Lower Power device
IR distance sensor: Left | UPenn ESE Vault | Sharp Microelectronics | GP2Y0A21YK0F | DigiKey | 1855-1062-ND | Through hole / use connector | GPIO | 4.5V | 5.5V | 30 | 40 | N/A | $11.84 | $6.63 | https://www.digikey.com/en/products/detail/sharp-socle-technology/GP2Y0A21YK0F/720159 | $11.84 | Sensor Module, no Devboard, Using Two sensor on Left and Right
IR distance sensor: Right | UPenn ESE Vault | Sharp Microelectronics | GP2Y0A21YK0F | DigiKey | 1855-1062-ND | Through hole / use connector | GPIO | 4.5V | 5.5V | 30 | 40 | N/A | $11.84 | $6.63 | https://www.digikey.com/en/products/detail/sharp-socle-technology/GP2Y0A21YK0F/720159 | $11.84 | Sensor Module, no Devboard, Using Two sensor on Left and Right
Haptic Motor Driver: Left | Manually made connector in SchLib and PcbLib | Texas Instruments | DRV2605LDGSR | DigiKey | 296-40032-2-ND | SMT | I2C | 2V | 5.2V | 2.5 | 3.5 | 0.65 | $2.84 | $1.39 | https://www.digikey.com/en/products/detail/adafruit-industries-llc/2305/5356831?gad_source=1 | $7.95 | Two motors placed either side of the helmet, one driver controls one motor
Haptic Motor Driver: Right | Manually made connector in SchLib and PcbLib | Texas Instruments | DRV2605LDGSR | DigiKey | 296-40032-2-ND | SMT | I2C | 2V | 5.2V | 2.5 | 3.5 | 0.65 | $2.84 | $1.39 | https://www.digikey.com/en/products/detail/adafruit-industries-llc/2305/5356831?gad_source=1 | $7.95 | Two motors placed either side of the helmet, one driver controls one motor
Haptic Motor: Left | UPenn ESE Vault | Adafruit Industries LLC | 1201 | DigiKey | 1528-1177-ND | Through hole / use connector | N/A | 2V | 5V | 40 | 100 | N/A | $1.95 | $1.56 | https://www.adafruit.com/product/1201 | $1.95 | Two motors placed either side of the helmet, one driver controls one motor
Haptic Motor: Right | UPenn ESE Vault | Adafruit Industries LLC | 1201 | DigiKey | 1528-1177-ND | Through hole / use connector | N/A | 2V | 5V | 40 | 100 | N/A | $1.95 | $1.56 | https://www.adafruit.com/product/1201 | $1.95 | Two motors placed either side of the helmet, one driver controls one motor
Bluetooth Module | Manually made connector in SchLib and PcbLib | N/A | HC-05 | Amazon | N/A | Through hole / use connector | UART | 3.6V | 6V | 10 | 30 | 30 | $8.53 | N/A | https://www.amazon.com/Bluetooth-Converter-Wireless-Transceiver-Communication/dp/B08Z3J9Y8T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 | $8.53 | To receive navigational data
LED Stick: Left | Manually made connector in SchLib and PcbLib | SparkFun Electronics | COM-18354 | DigiKey | 1568-COM-18354-ND | Through hole / use connector | I2C | 5V | 5.5V | 231.2 | 272 | N/A | $10.95 | N/A | https://www.sparkfun.com/products/18354 | $10.95 | Left and Right Turn and brake signal use an multi color LED strip
LED Stick: Right | Manually made connector in SchLib and PcbLib | SparkFun Electronics | COM-18354 | DigiKey | 1568-COM-18354-ND | Through hole / use connector | I2C | 5V | 5.5V | 231.2 | 272 | N/A | $10.95 | N/A | https://www.sparkfun.com/products/18354 | $10.95 | Left and Right Turn and brake signal use an multi color LED strip
LED Stick: Brake | Manually made connector in SchLib and PcbLib | SparkFun Electronics | COM-18354 | DigiKey | 1568-COM-18354-ND | Through hole / use connector | I2C | 5V | 5.5V | 231.2 | 272 | N/A | $10.95 | N/A | https://www.sparkfun.com/products/18354 | $10.95 | Left and Right Turn and brake signal use an multi color LED strip
Opam | UPenn ESE Vault | Texas Instruments | LM358ADR | DigiKey | 296-14601-2-ND | SMT | GPIO | 3V | 30V | 1 | 2 | N/A | $0.43 | $0.10 | https://www.proto-advantage.com/store/product_info.php?products_id=3100051 | $5.29 | Breakout board not found, will assemble manually
 | The 3.3 Supply
 | Component | Current Consumption, worst case (mA)
 | MCU and Wi-Fi | 500mA
 | 3-axis Accelerometer | 1mA
 |  | Total: 501mA
 |  | Total with 10% Safety Margin: 550mA
 | The 5V Supply
 | Component | Current Consumption, worst case (mA)
 | IR distance sensor: Left | 40mA
 | IR distance sensor: Right | 40mA
 | Bluetooth Module | 30mA
 | LED Stick: Left | 272mA
 | LED Stick: Right | 272mA
 | LED Stick: Brake | 272mA
 | Haptic Motor Driver: Left | 4mA
 | Haptic Motor Driver: Right | 4mA
 | Haptic Motor: Left | 100mA
 | Haptic Motor: Right | 100mA
 | OpAm | 2mA
 |  | Total: 1136mA
 |  | Total with 10% Safety Margin: 1249.2 mA (~1300mA)

Sheet: Template (Example)
Team Number | 1337
Team Name | The EXE Files
Team Member # 1 | John
Team Member # 2 | Jay
Row of totals |  |  |  |  |  |  |  |  | 1157.3 | 1705 | 14.005 |  | $47.85 | $45.63
Component | Digital Component Location (For A02G assignment) | Manufacturer | Manufacturer part number (MPN) | Distributor | Distributor Part Number | Mounting Type | Voltage (Min) | Voltage (Max) | Current Consumption, typical case (mA) | Current Consumption, worst case (mA) | Quiescent current (mA) | Interface to MCU | Cost QTY 1 | Cost QTY 1K | Dev Board Link (Required) | Dev Board Price | Comments
MCU and Wi-Fi | UPenn ESE Vault | Microchip | ATSAMW25H18-MR210PB1952 | DigiKey | ATSAMW25H18-MR210PB1952-ND | SMT | 2.7V | 4.3V | 200 | 500 | 1 | N/A | $12.05 | $10.92 | https://www.digikey.com/en/products/detail/microchip-technology/ATSAMW25-XPRO/5235960 | $41.04 | ESE5160 MCU and WiFi SoC
Soil Moisture Sensor | Manually made connector in SchLib and PcbLib | Sparkfun | SEN-13637 | DigiKey | 1568-1670-ND | Through hole / use connector | 2.7V | 4.3V (MCU Limit) | 20 | 30 | 10 | Analog (ADC) x 1 | $6.95 | $6.95 | https://www.digikey.com/product-detail/en/sparkfun-electronics/SEN-13637/1568-1670-ND/7400839 | $6.95 | For prototype, dev board can act as the sensor
Motor Driver | Manufacturer Part Search (MPS) | TI | DRV8833PWPR | DigiKey | 296-29434-2-ND | SMT | 2.7V | 10.8V | 500 | 600 | 2 | 3 GPIO | $2.15 | $1.06 | http://www.proto-advantage.com/store/product_info.php?products_id=2200233 | ~6 | Does not have dev board - but we can use the following from ProtoAdvantage: http://www.proto-advantage.com/store/product_info.php?products_id=2200233
Water Pump | Manually made connector in SchLib and PcbLib | DRFROBOT | FIT0563 | DigiKey | 1738-1398-ND | Through hole / use connector | 6V | 12V | 425 | 525 | 1 | N/A | $9.20 | $9.20 | https://www.mouser.com/ProductDetail/DFRobot/FIT0563?qs=vdi0iO8H4N1ZbaY6gO4Uqg%3D%3D | $9.20 | Actuator
OLED Display | Manually made connector in SchLib and PcbLib | Adafruit | 326 | DigiKey | 1528-1220-ND | Through hole / use connector | 3.5V | 4.2V | 12.3 | 50 | 0.005 | I2C | $17.50 | $17.50 | https://www.adafruit.com/product/326 | $17.50 | Fulfills the I2C peripheral requirement
