saurabhparulekar24/HelMate/A03G_schematics-ii/A03G non pcba bom - Circuit Crusaders.xlsx

Sheet: Template (For you to use)
Bill of Materials for Components Not Mounted on PCBA
Team Number | 26
Team Name | Circuit Crusaders
Team Member # 1 | Saurabh Sandeep Parulekar
Team Member # 2 | Binh Nguyen
Row of totals |  |  |  |  | $42.49
Component | Manufacturer | Manufacturer part number (MPN) | Distributor | Distributor Part Number (DPN) | Cost QTY 1 | # per prototype | Cost per Proto | Purchase Link | Comments
IR Distance Sensor | Sharp | GP2Y0A21YK0F | DigiKey | 1855-1062-ND | $11.84 | 2 | $23.68 | https://www.digikey.com/en/products/detail/sharp-socle-technology/GP2Y0A21YK0F/720159 | Used for Detecting Obstacles on either side of the Helmet
Haptic Motor | Adafruit | 1201 | DigiKey | 1528-1177-ND | $1.95 | 2 | $3.90 | https://www.digikey.com/en/products/detail/adafruit-industries-llc/1201/5353637 | Used fo indicating turns to the Rider
Bluetooth Module | DSD Tech | HC-05 | Amazon | N/A | $9.99 | 1 | $9.99 | https://www.amazon.com/DSD-TECH-HC-05-Pass-through-Communication/dp/B01G9KSAF6 | To Recevie Navigational data from Phone
LED Strip | Sparkfun | COM-18354 | DigiKey | 1568-COM-18354-ND | $10.95 | 3 | $32.85 | https://www.digikey.com/en/products/detail/sparkfun-electronics/COM-18354/14645588 | Turn Light indicator and Brake Light
Potentiometer | Bourns Inc | 3362P-1-103LF | DigiKey | 3362P-103LF-ND | $1.03 | 2 | $2.06 | https://www.digikey.com/en/products/detail/bourns-inc./3362P-1-103LF/1088412 | Potentiometer to Adjust the distance sensor sensing distance
Electolytic Cap | Kemet | ESC227M035AH1AA | DigiKey | 399-6083-ND | $0.45 | 2 | $0.90 | https://www.digikey.com/en/products/detail/kemet/ESC227M035AH1AA/2712550 | Connected to IR distance sensor power as per datasheet recommendation
4 2.54mm Pos Connector(J3) | TE Connectivity AMP Connectors | 5-104363-3 | DigiKey | A32565-ND | $1.69 | 1 | $1.69 | https://www.digikey.com/en/products/detail/te-connectivity-amp-connectors/5-104363-3/1089965 | Connector for MCU schematic
3 Pos 2.54mm Connector(J6,J7) | TE Connectivity AMP Connectors | 5-104363-2 | DigiKey | A32564-ND | $1.41 | 2 | $2.82 | https://www.digikey.com/en/products/detail/te-connectivity-amp-connectors/5-104363-2/1089964 | 2x IR distance sensor connector
2x3 Wurth Connector(J10, J11, J12, J13, J14,J15) | JST Sales America Inc. | SM04B-SRSS-TB | DigiKey | 455-SM04B-SRSS-TBTR-ND | $0.60 | 6 | $3.60 | https://www.digikey.com/en/products/detail/jst-sales-america-inc/SM04B-SRSS-TB/926710 | Connector for LED Strips
CONN HEADER SMD 2POS 2MM( J1) | JST Sales America Inc. | B2B-PH-SM4-TBT | DigiKey | 455-B2B-PH-SM4-TBTTR-ND | $0.81 | 1 | $0.81 | https://www.digikey.com/en/products/detail/jst-sales-america-inc/B2B-PH-SM4-TBT/2137328 | Lipo Battery Connector
Connectors, Interconnects Rectangular Connectors Headers, Male Pins (J16) | Adam Tech | PH1-06-UA | DigiKey | 2057-PH1-06-UA-ND | $0.13 | 1 | $0.13 | https://www.digikey.com/en/products/detail/PH1-06-UA/2057-PH1-06-UA-ND/9830394?curr=usd | Bluetooth
2x3 Wurth Connector(P7) | Würth Elektronik | 61200621621 | DigiKey | 732-5394-ND | $0.48 | 1 | $0.48 | https://www.digikey.com/en/products/detail/61200621621/732-5394-ND/4846913?curr=usd | Haptic Motor
2x3 Wurth Connector(P9) | Würth Elektronik | 61200621721 | DigiKey | 732-5404-ND | $1.16 | 1 | $1.16 | https://www.digikey.com/en/products/detail/61200621721/732-5404-ND/4846914?curr=usd | Power

Sheet: Template (Example)
Bill of Materials for Components Not Mounted on PCBA
Team Number | 1337
Team Name | The Exe Files
Team Member # 1 | John
Team Member # 2 | Jay
Row of totals |  |  |  |  | $35.48
Component | Manufacturer | Manufacturer part number (MPN) | Distributor | Distributor Part Number (DPN) | Cost QTY 1 | # per prototype | Cost per Proto | Purchase Link | Comments
Stepper Motor | Sparkfun | ROB-09238 | DigiKey | 1568-1105-ND | $0.00 | 1 | $0.00 | https://www.digikey.com/short/vj2pwq99 | For moving the gantry
6-pin IDC Connector | Würth Elektronik | 61200621621 | DigiKey | 732-5394-ND | $0.48 | 4 | $1.92 | https://www.digikey.com/short/mtnw508w | For connecting the stepper motor and two debug headers
Red LED | Everlight Electronics Co Ltd | EALP05RDHRA0-ND | DigiKey | EALP05RDHRA0-ND | $35.00 | 2 | $70.00 | https://www.digikey.com/short/20qrzv73 | Through hole indication LEDs
