saurabhparulekar24/HelMate/A01G_components-pins-power/images/61023_charts.png

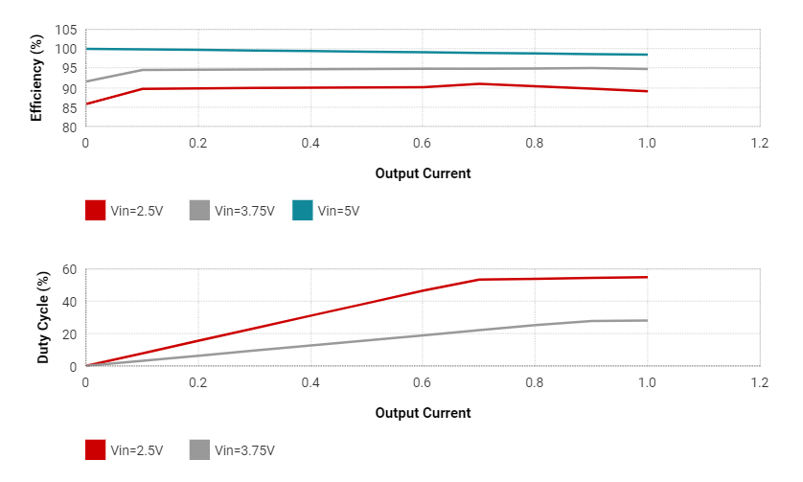
A01G_components-pins-power/images/61023_charts.png
