saurabhparulekar24/HelMate/A01G_components-pins-power/images/62082.png

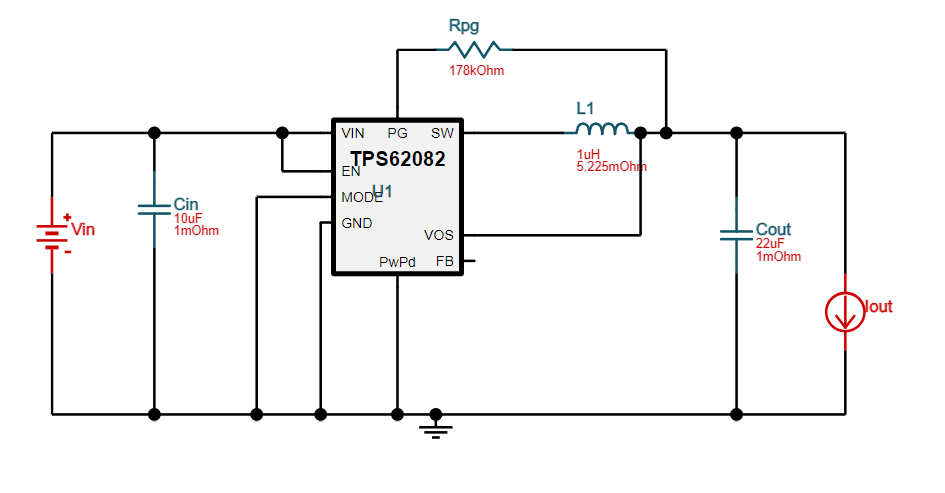
A01G_components-pins-power/images/62082.png
