saurabhparulekar24/HelMate/A01G_components-pins-power/images/62082_charts.png

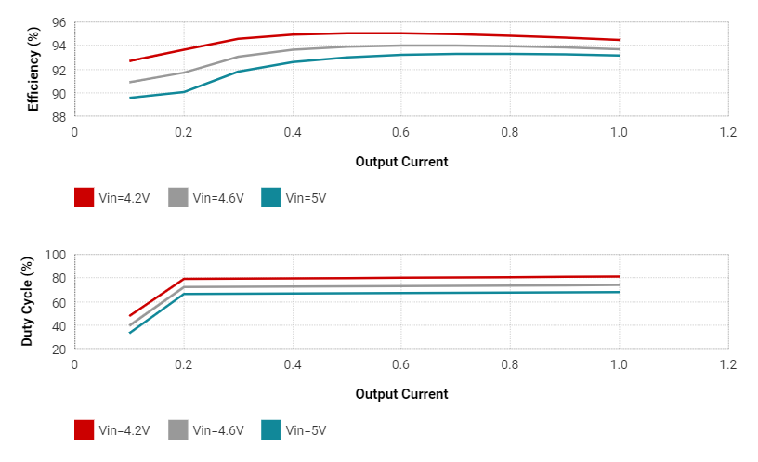
A01G_components-pins-power/images/62082_charts.png
