saurabhparulekar24/HelMate/A01G_components-pins-power/images/GPIO_interface.png

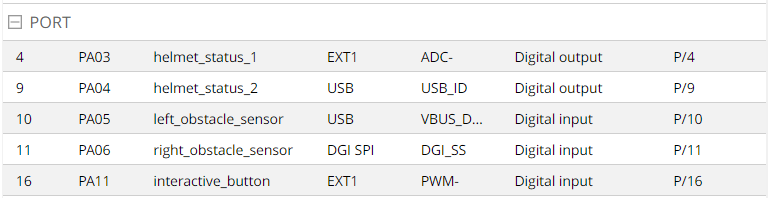
A01G_components-pins-power/images/GPIO_interface.png
