saurabhparulekar24/HelMate/A01G_components-pins-power/images/Sercom_interface.png

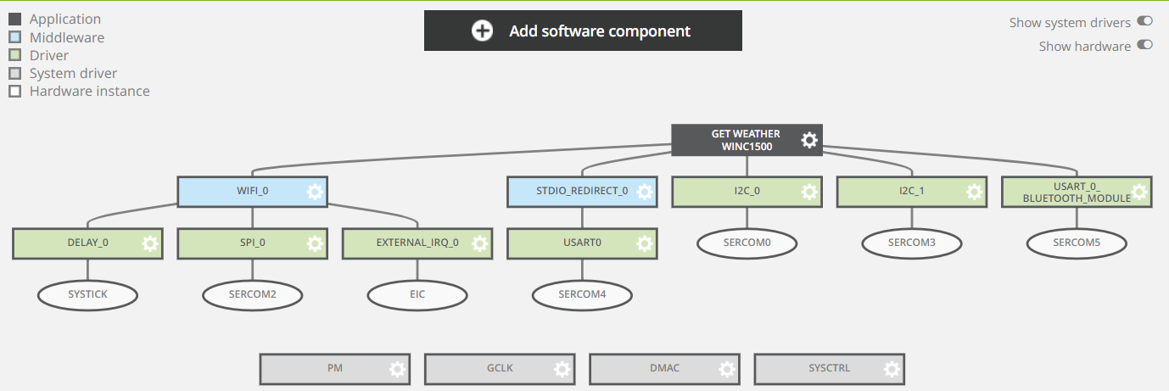
A01G_components-pins-power/images/Sercom_interface.png
