saurabhparulekar24/HelMate/A01G_components-pins-power/images/tps61023.png

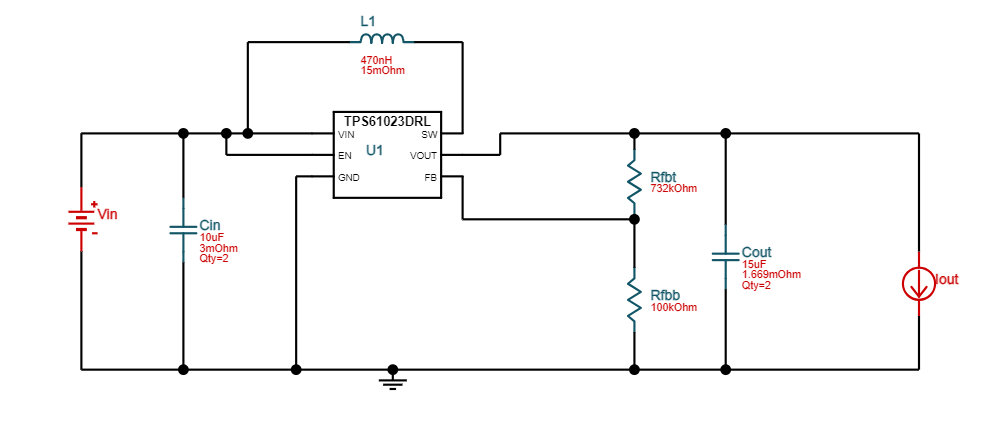
A01G_components-pins-power/images/tps61023.png
