saurabhparulekar24/HelMate/A09G_the-bootloader-waltz/images and Captures/hardware_setup.jpg

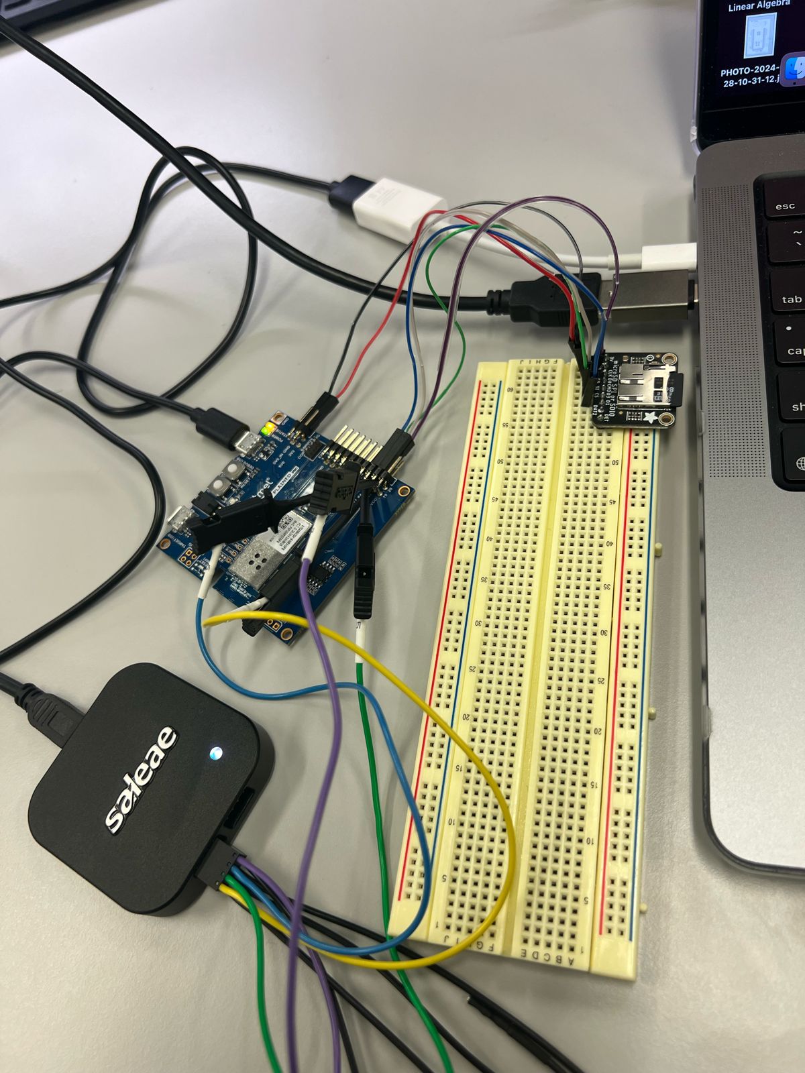
A09G_the-bootloader-waltz/images and Captures/hardware_setup.jpg
