saurabhparulekar24/HelMate/A11G_board-bringup/Images/5V_1300mA_Load_Closeup.jpeg

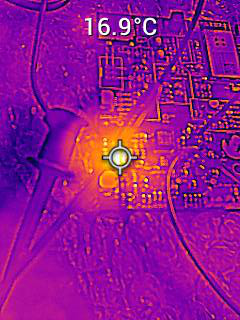
A11G_board-bringup/Images/5V_1300mA_Load_Closeup.jpeg
