saurabhparulekar24/HelMate/A11G_board-bringup/Images/Board Connections.jpg

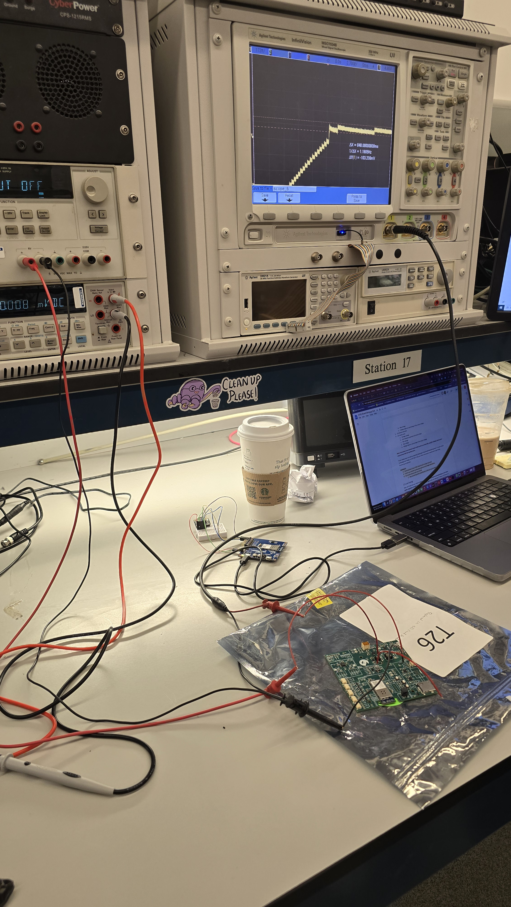
A11G_board-bringup/Images/Board Connections.jpg
