saurabhparulekar24/HelMate/A11G_board-bringup/Images/Board_Connections.jpg

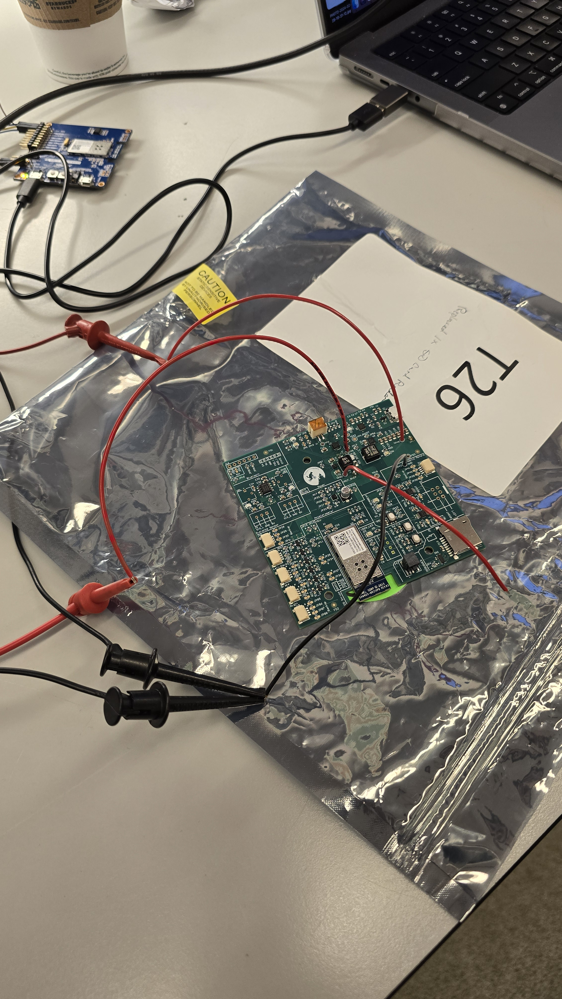
A11G_board-bringup/Images/Board_Connections.jpg
