saurabhparulekar24/HelMate/A11G_board-bringup/Images/boost/Boost_MinMaxVoltage3.png

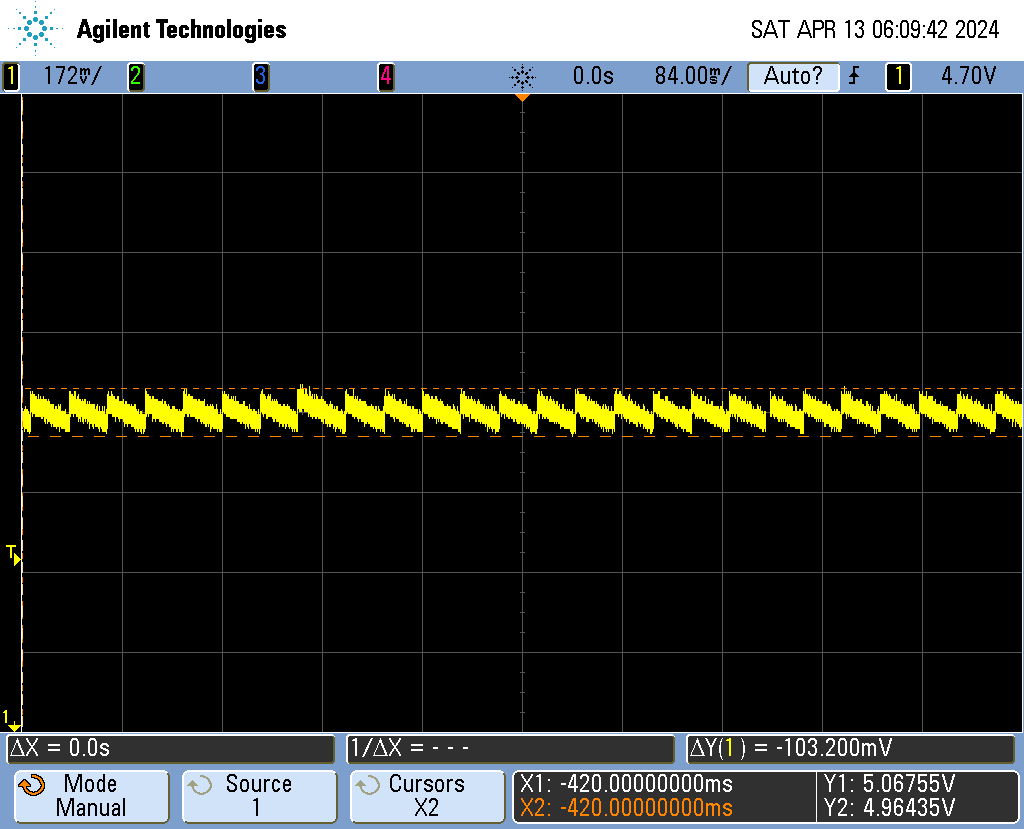
A11G_board-bringup/Images/boost/Boost_MinMaxVoltage3.png
