saurabhparulekar24/HelMate/A11G_board-bringup/Images/boost/Boost_SteadyState.png

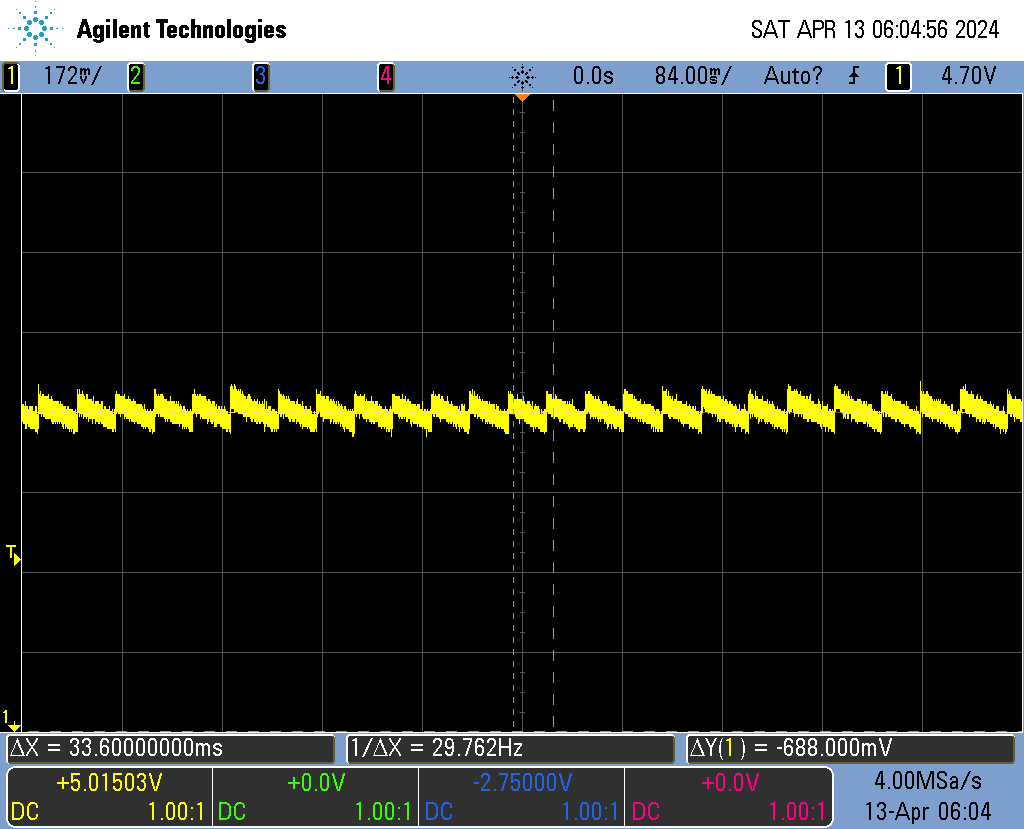
A11G_board-bringup/Images/boost/Boost_SteadyState.png
