saurabhparulekar24/HelMate/A11G_board-bringup/Images/boost/Boost_Transient1.png

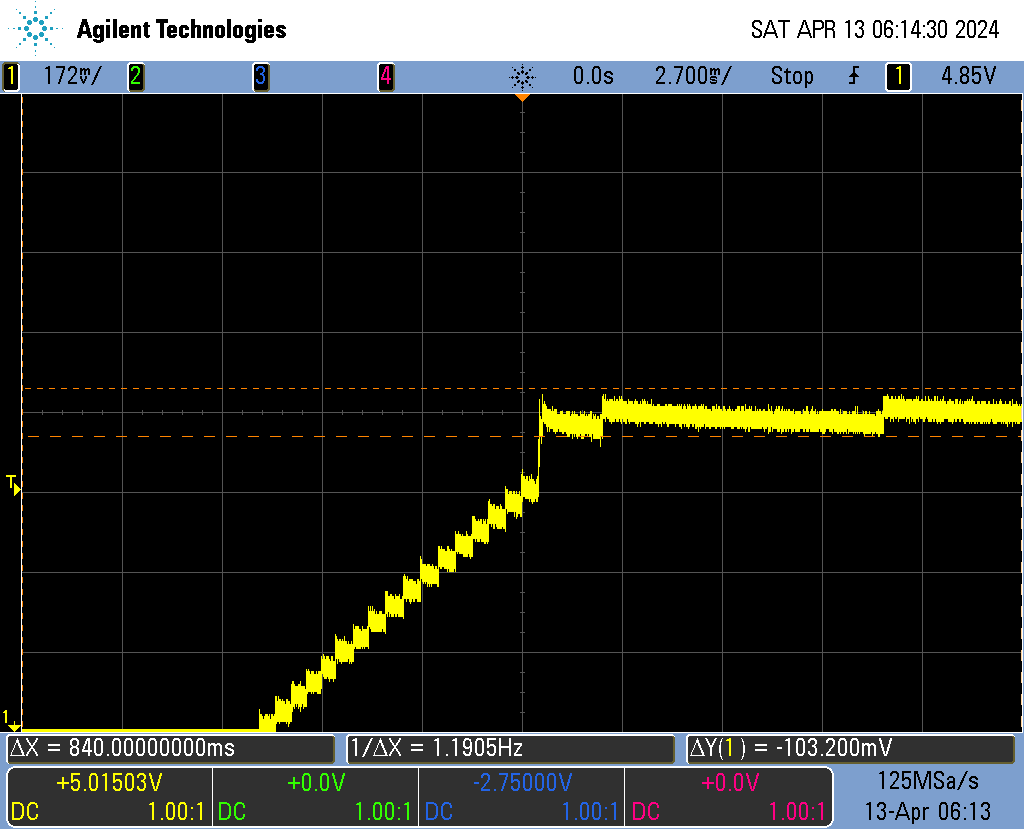
A11G_board-bringup/Images/boost/Boost_Transient1.png
