saurabhparulekar24/HelMate/A11G_board-bringup/Images/boost/Boost_Transient2.png

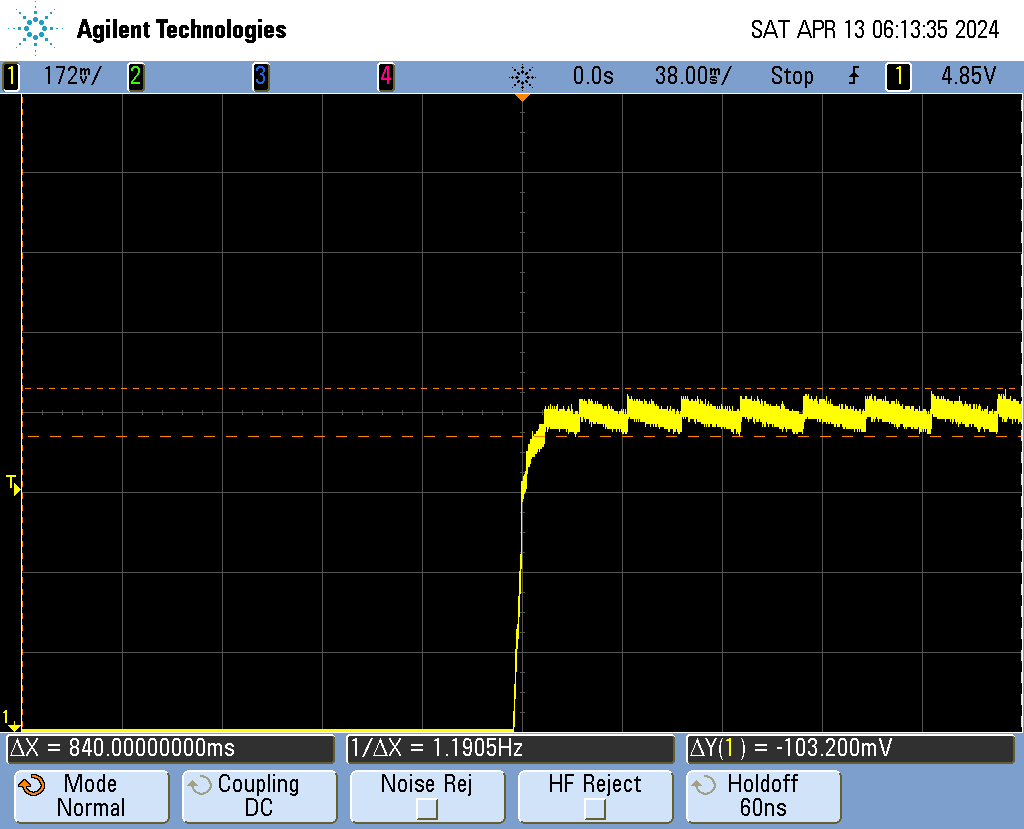
A11G_board-bringup/Images/boost/Boost_Transient2.png
