saurabhparulekar24/HelMate/A11G_board-bringup/Images/buck/Buck_1.png

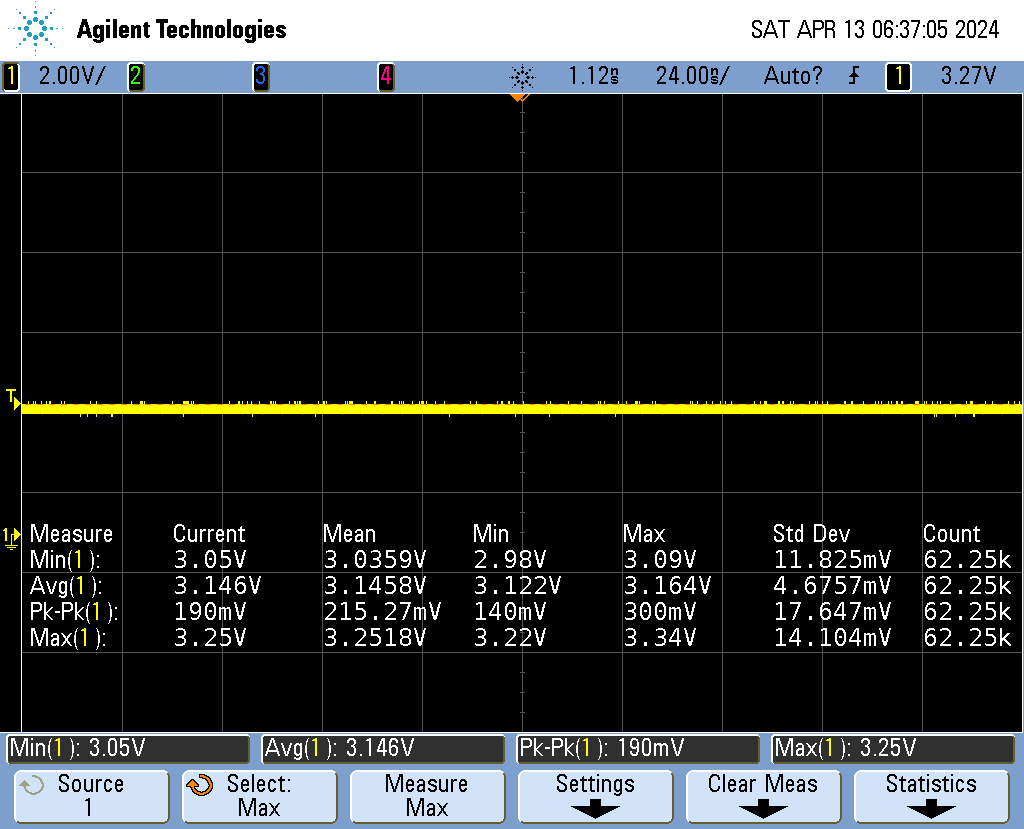
A11G_board-bringup/Images/buck/Buck_1.png
