saurabhparulekar24/HelMate/A11G_board-bringup/Images/CLI.gif

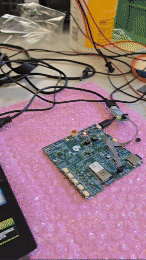
A11G_board-bringup/Images/CLI.gif
