saurabhparulekar24/HelMate/A11G_board-bringup/Images/E-LoadChart.JPG

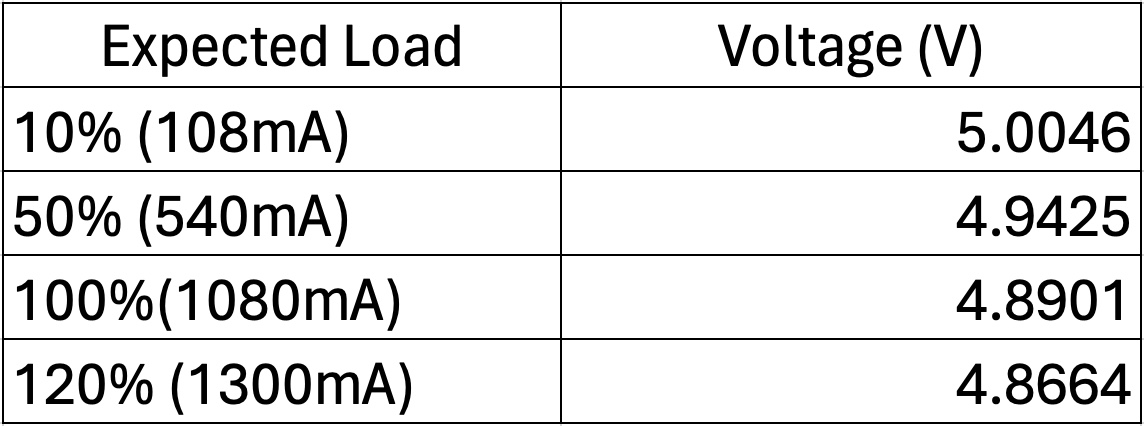
A11G_board-bringup/Images/E-LoadChart.JPG
