saurabhparulekar24/HelMate/A11G_board-bringup/Images/from_charger_board.jpg

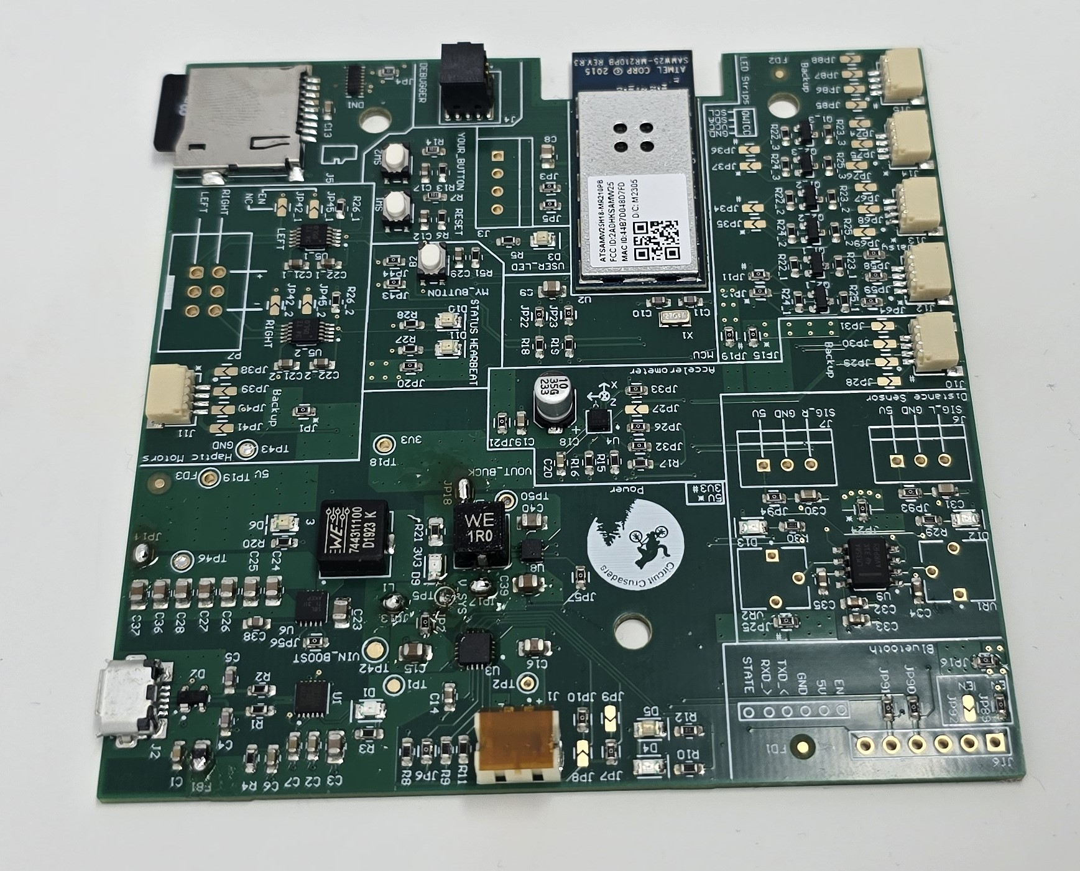
A11G_board-bringup/Images/from_charger_board.jpg
