saurabhparulekar24/HelMate/A11G_board-bringup/Images/from_wifi_board.jpg

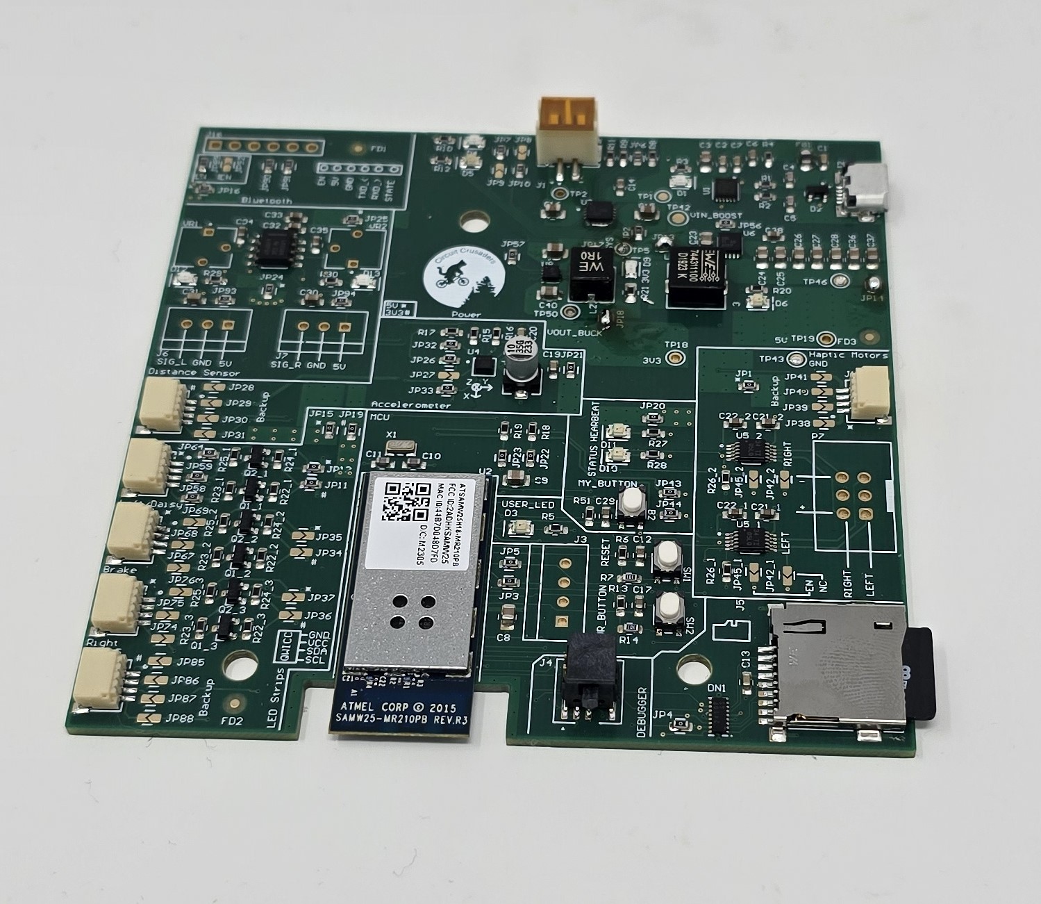
A11G_board-bringup/Images/from_wifi_board.jpg
