saurabhparulekar24/HelMate/A11G_board-bringup/Images/Power system.png

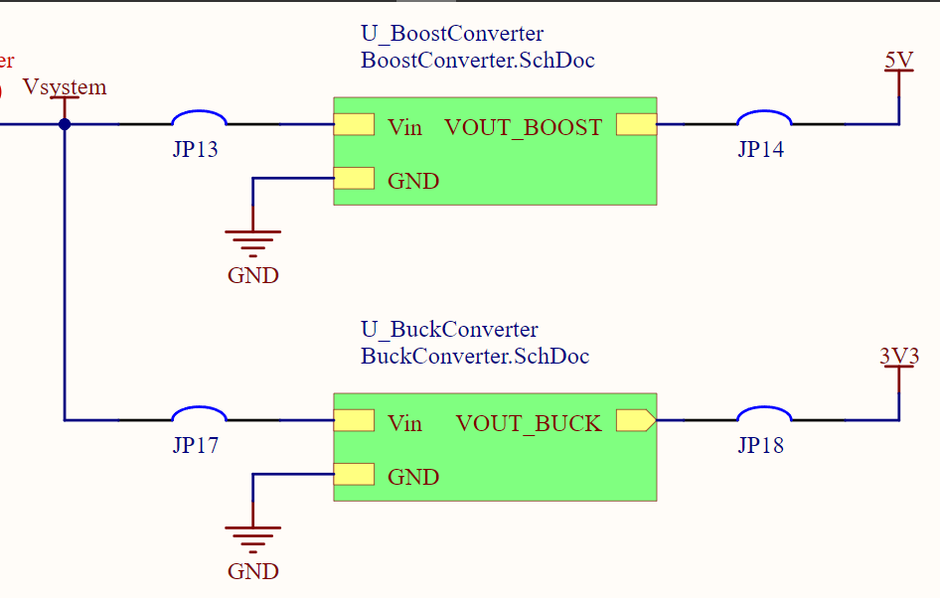
A11G_board-bringup/Images/Power system.png
