saurabhparulekar24/HelMate/A11G_board-bringup/Images/Sdcard.png

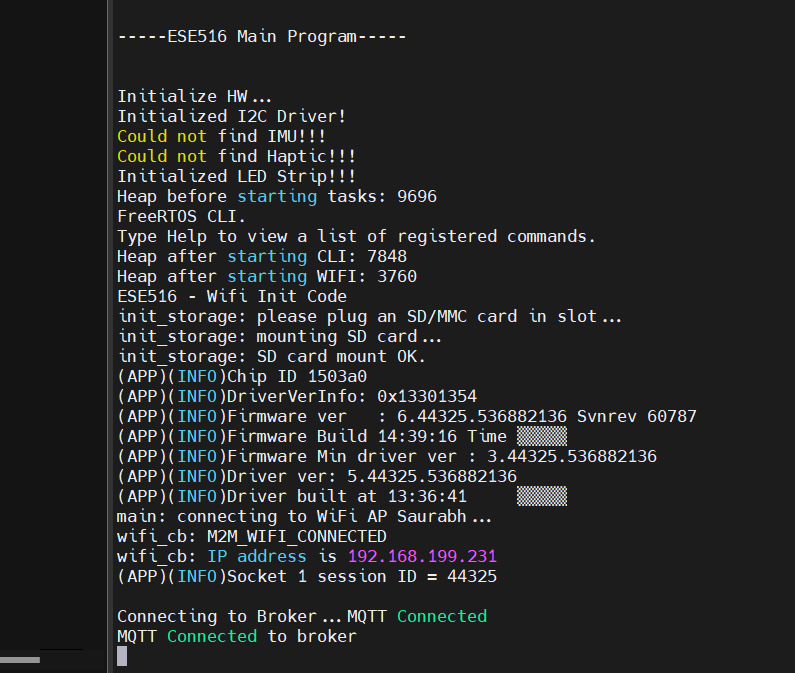
A11G_board-bringup/Images/Sdcard.png
