saurabhparulekar24/HelMate/A11G_board-bringup/Images/Target_Voltage.png

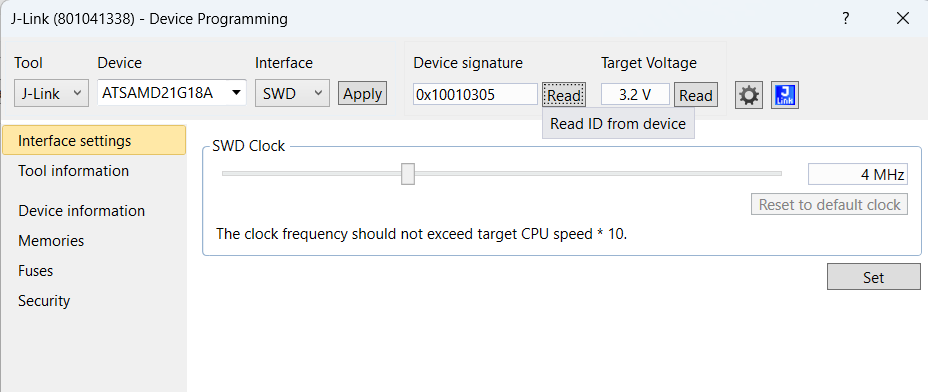
A11G_board-bringup/Images/Target_Voltage.png
