saurabhparulekar24/HelMate/A11G_board-bringup/Images/top_photo_board.jpg

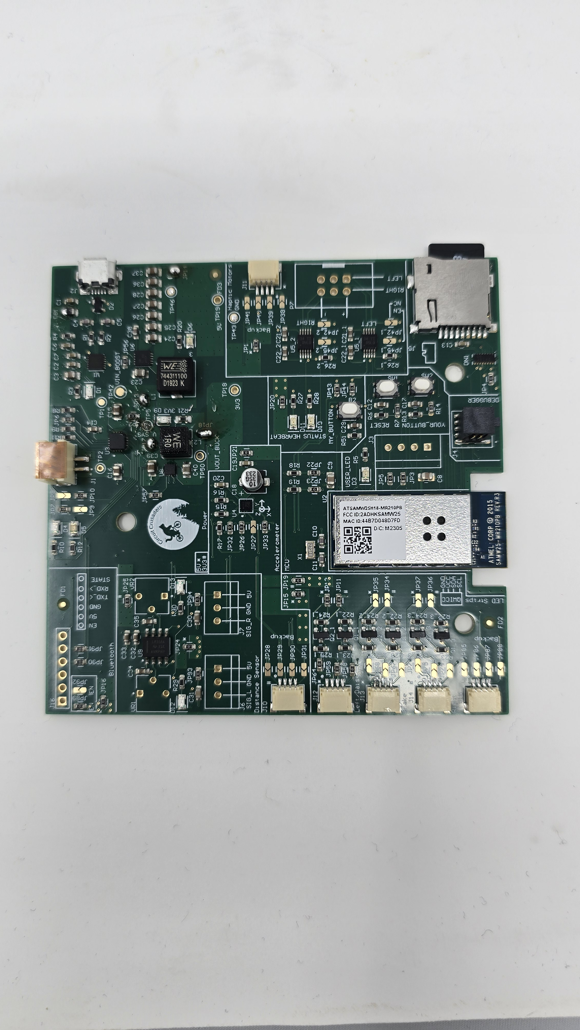
A11G_board-bringup/Images/top_photo_board.jpg
