saurabhparulekar24/HelMate/A03G_schematics-ii/Altium Files/Draftsman.pdf

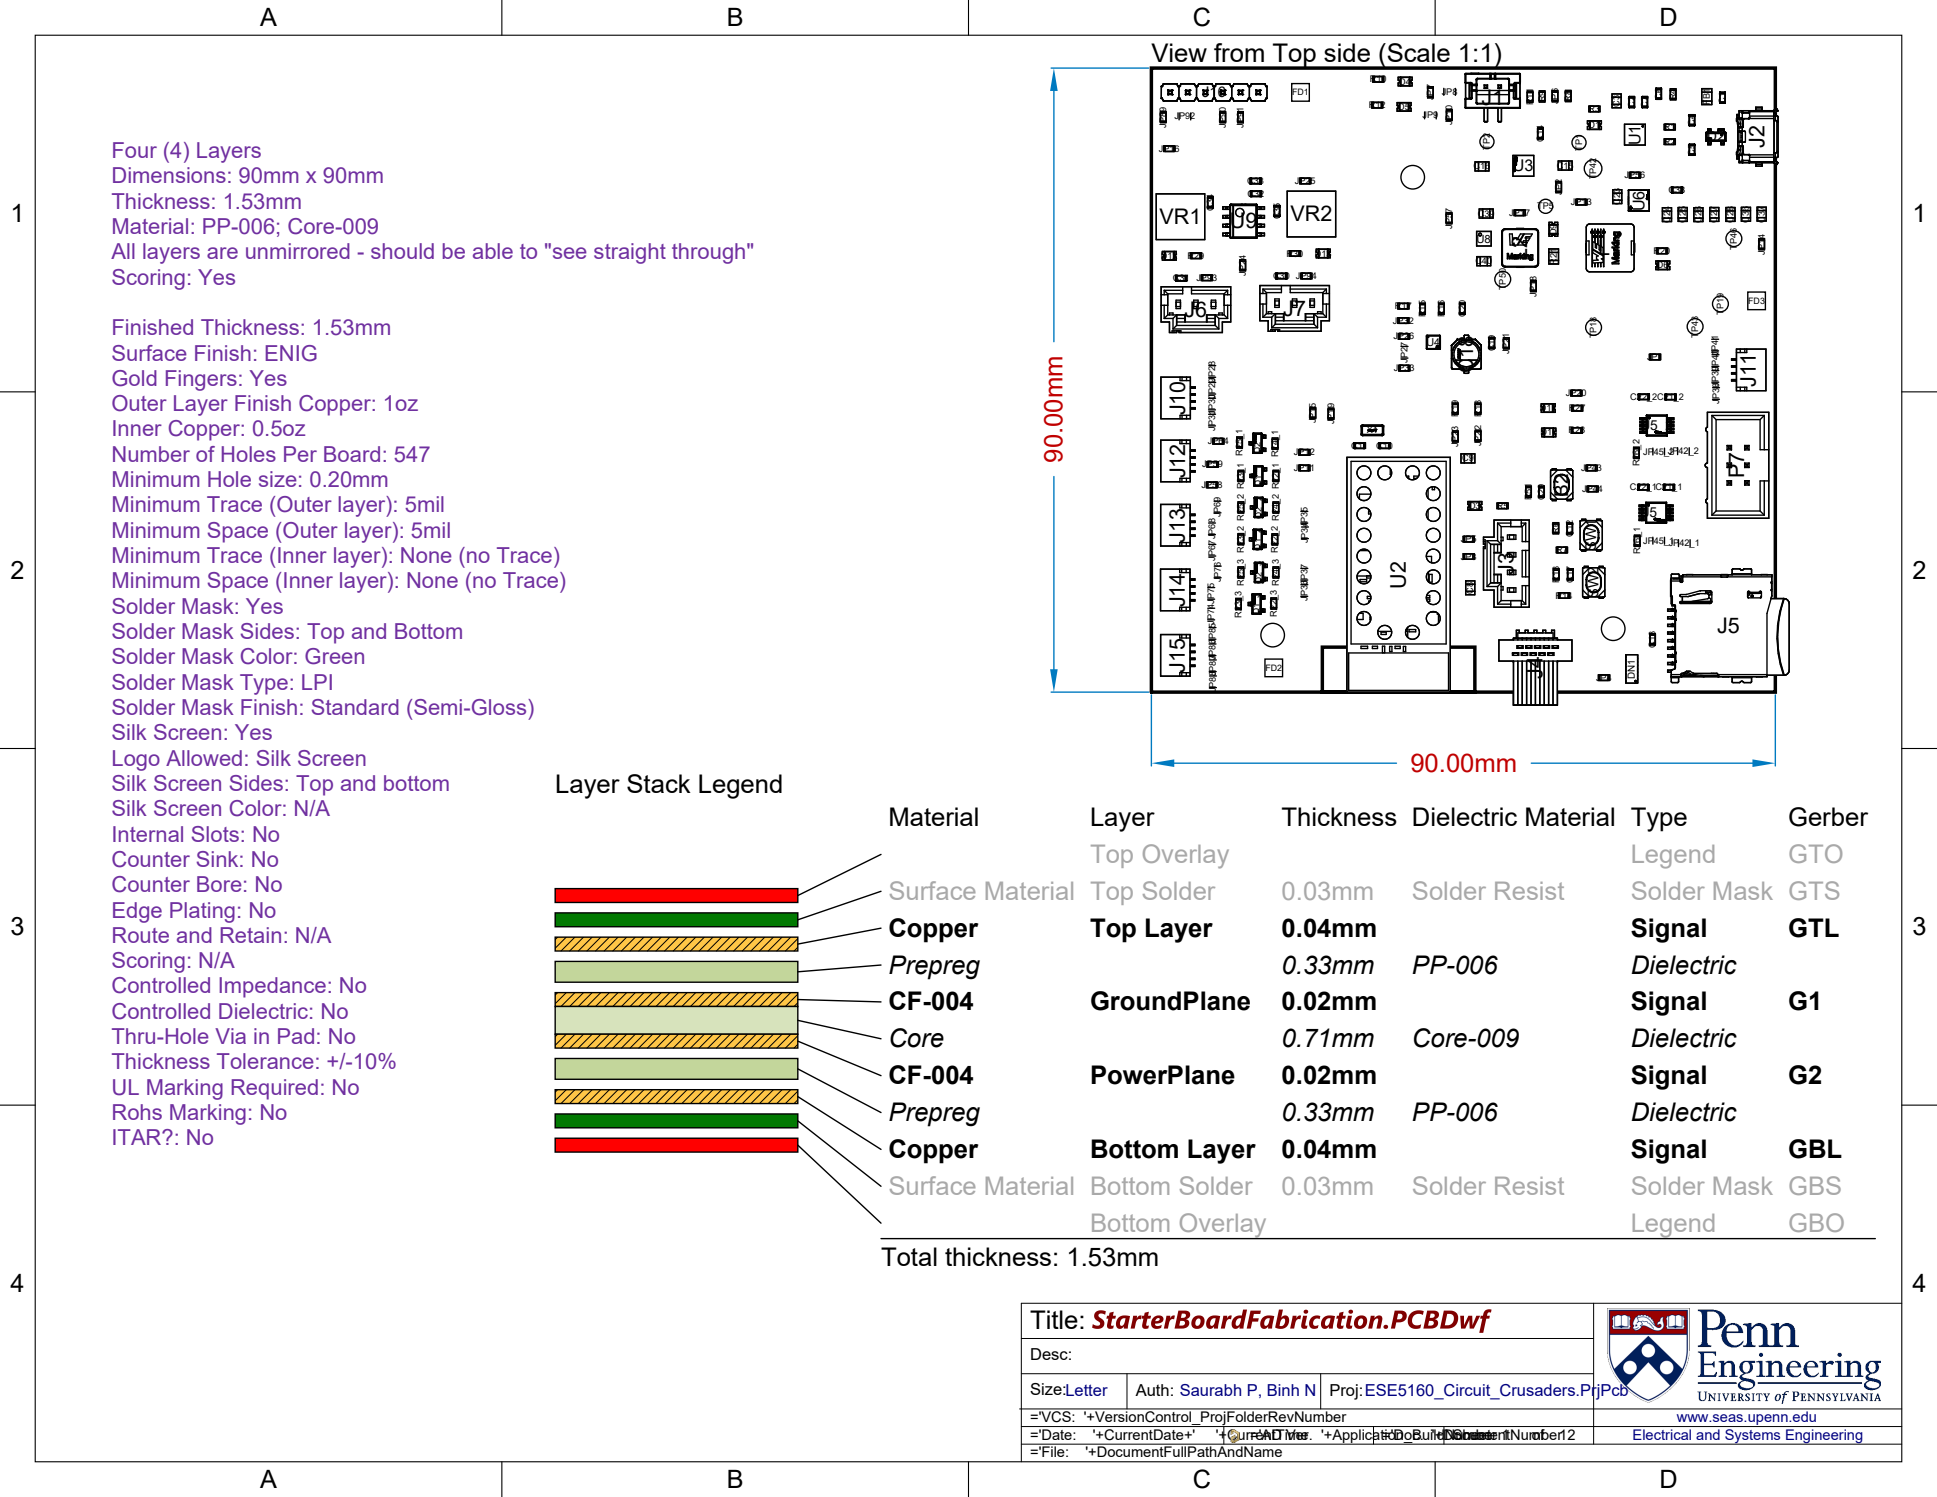
[picture p97: page 1]

View from Top side (Scale 1:1)

Four (4) Layers
Dimensions: 90mm x 90mm
Thickness: 1.53mm
Material: PP-006; Core-009
All layers are unmirrored - should be able to "see straight through"

Finished Thickness: 1.53mm
Surface Finish: ENIG
Gold Fingers: Yes
Outer Layer Finish Copper: 1oz
Inner Copper: 0.5oz
Number of Holes Per Board: 547

Minimum Hole size: 0.20mm
Minimum Trace (Outer layer): 5mil
Minimum Space (Outer layer): 5mil
Minimum Trace (Inner layer): None (no Trace)
Minimum Space (Inner layer): None (no Trace)
Solder Mask: Yes
Solder Mask Sides: Top and Bottom
Solder Mask Color: Green
Solder Mask Type: LPI
Solder Mask Finish: Standard (Semi-Gloss)
Silk Screen: Yes
Logo Allowed: Silk Screen

Silk Screen Sides: Top and bottom
Silk Screen Color: N/A
Internal Slots: No
Counter Sink: No
Counter Bore: No
Edge Plating: No
Route and Retain: N/A
Scoring: N/A
Controlled Impedance: No
Controlled Dielectric: No
Thru-Hole Via in Pad: No
Thickness Tolerance: +/-10%
UL Marking Required: No
Rohs Marking: No
ITAR?: No

www.seas.upenn.edu

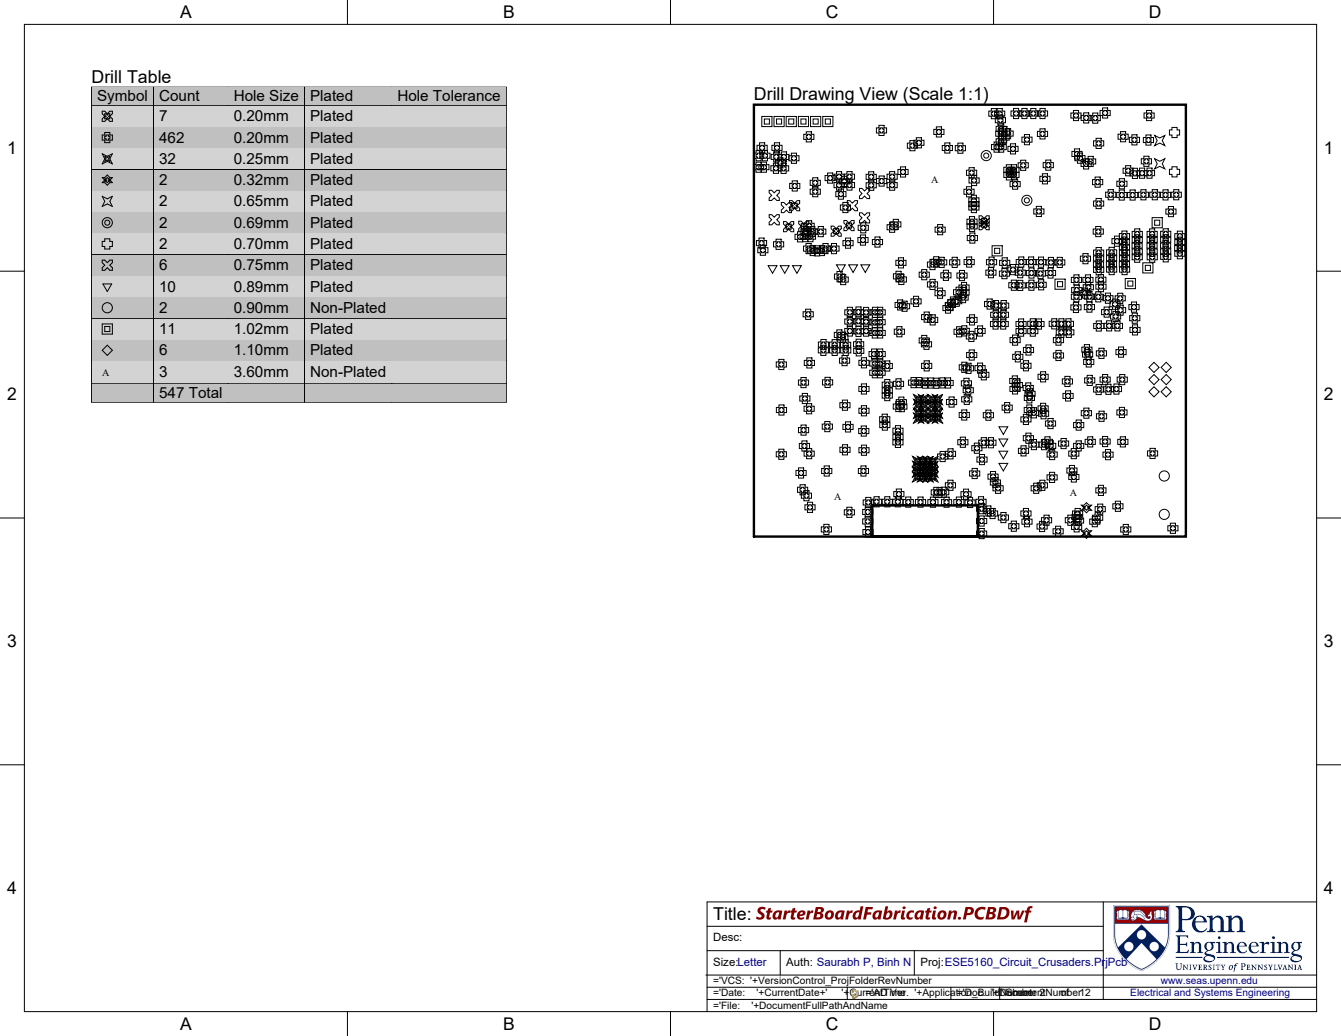
[picture p98: page 2]
547 Total; Hole Size; Hole Tolerance; Drill Table

Drill Drawing View (Scale 1:1)

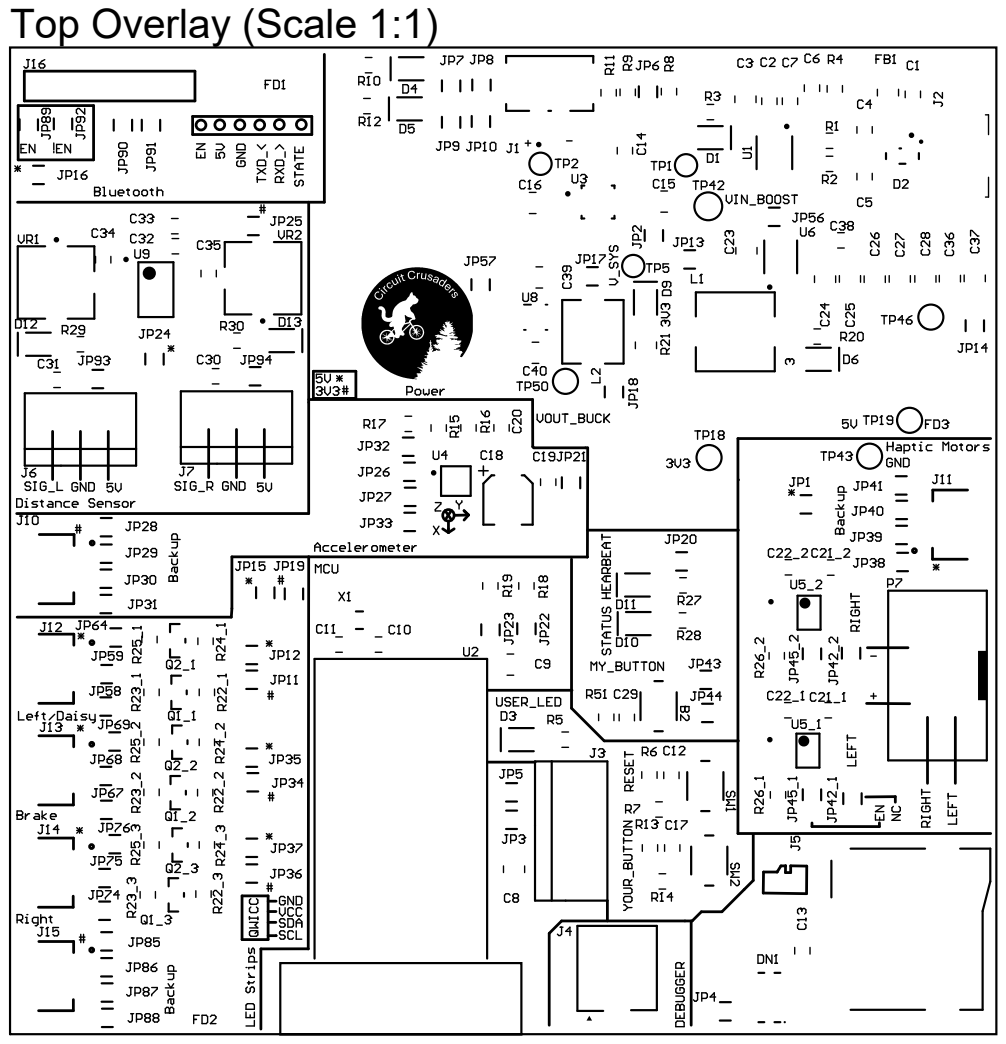
[picture p99: page 3]

Top Overlay (Scale 1:1)

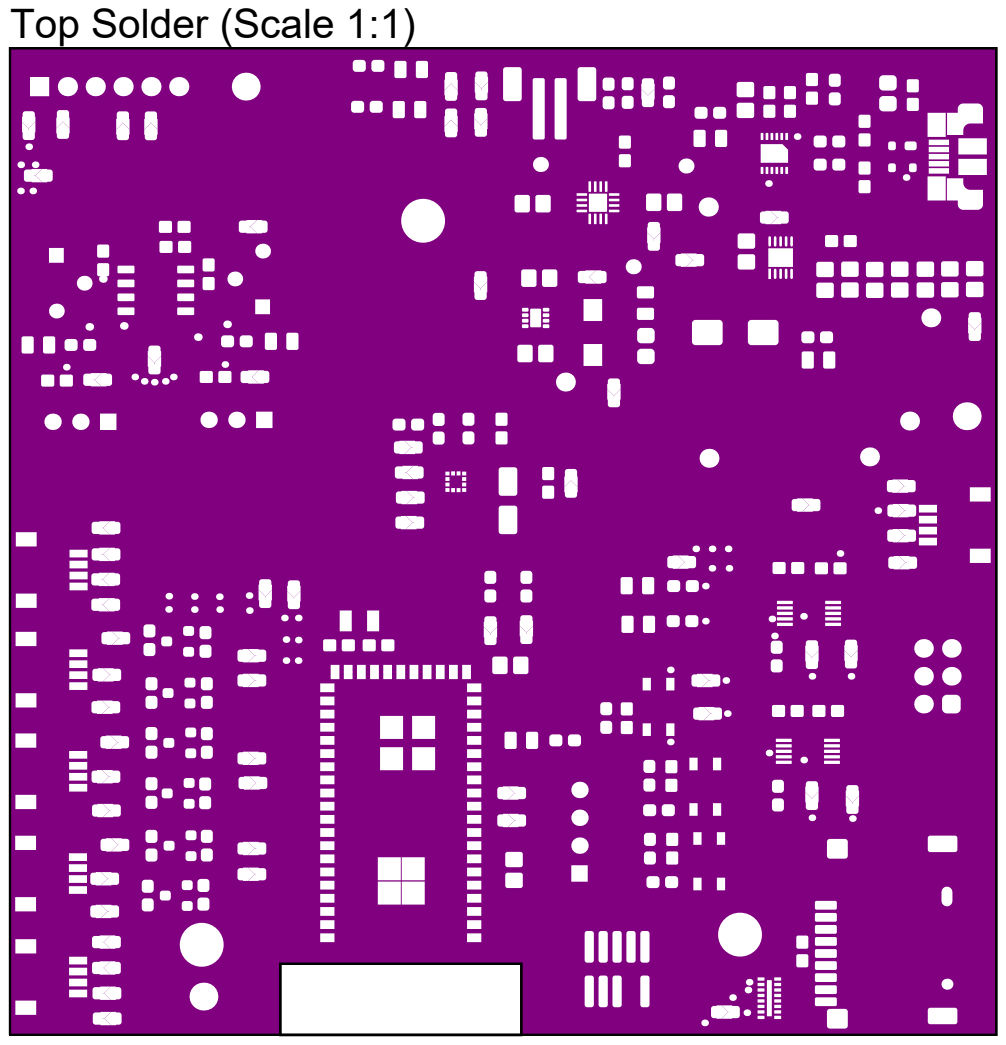
[picture p100: page 4]

Top Solder (Scale 1:1)

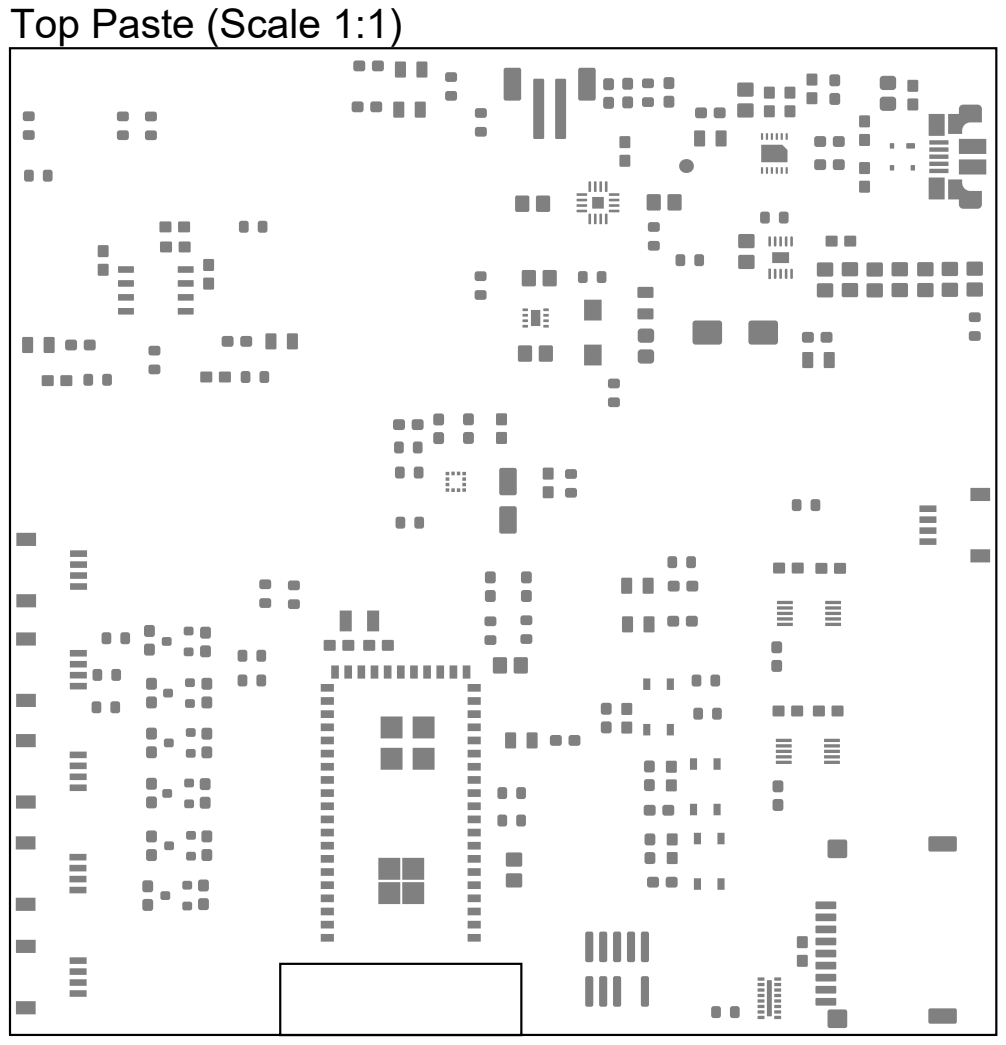
[picture p101: page 5]

Top Paste (Scale 1:1)

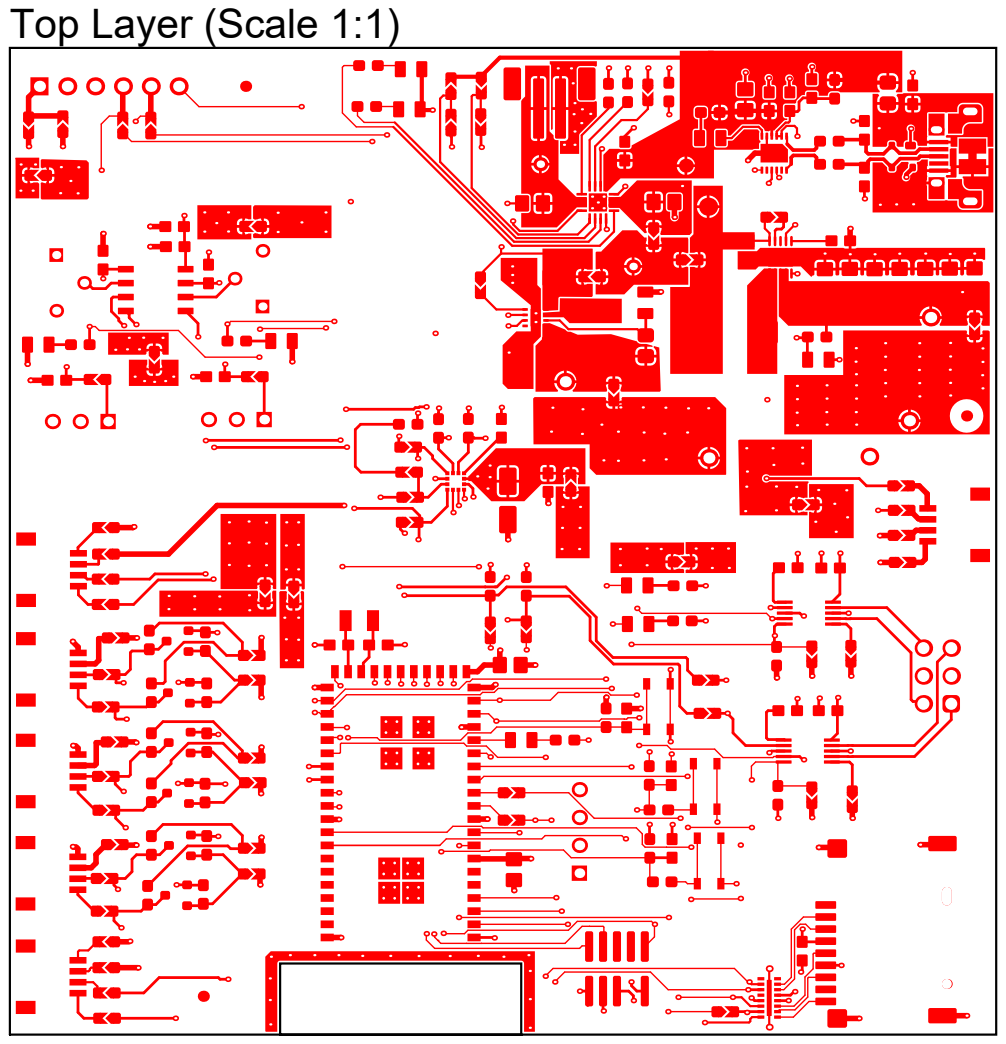
[picture p102: page 6]

Top Layer (Scale 1:1)

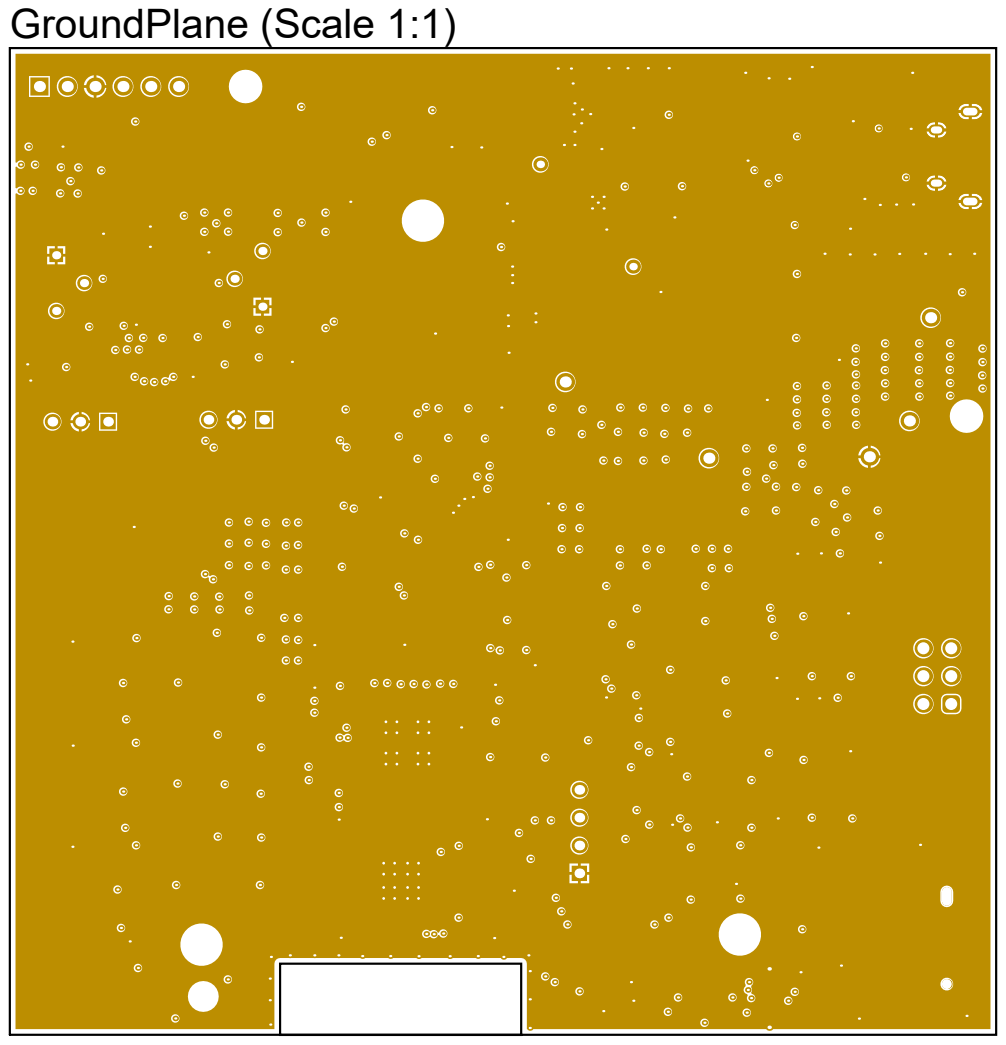
[picture p103: page 7]
GroundPlane (Scale 1:1)

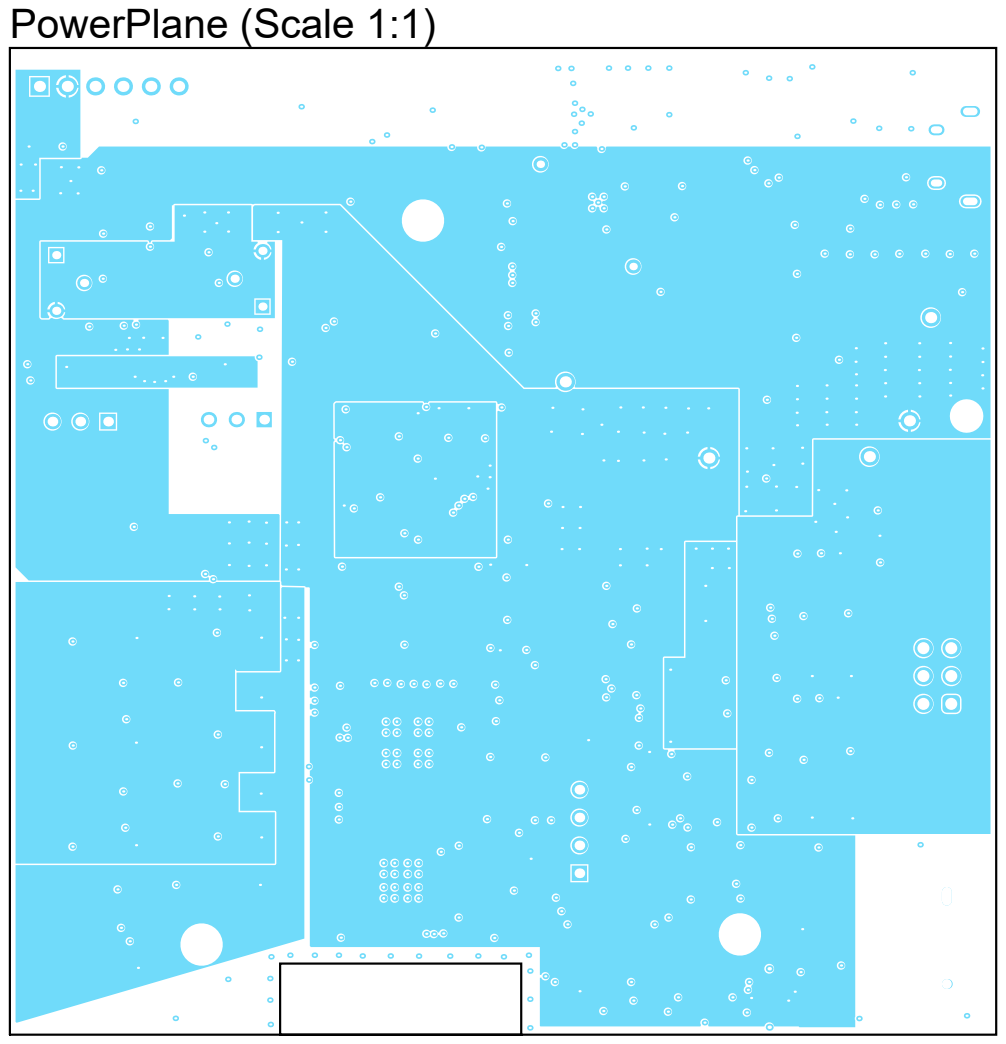
[picture p104: page 8]
PowerPlane (Scale 1:1)

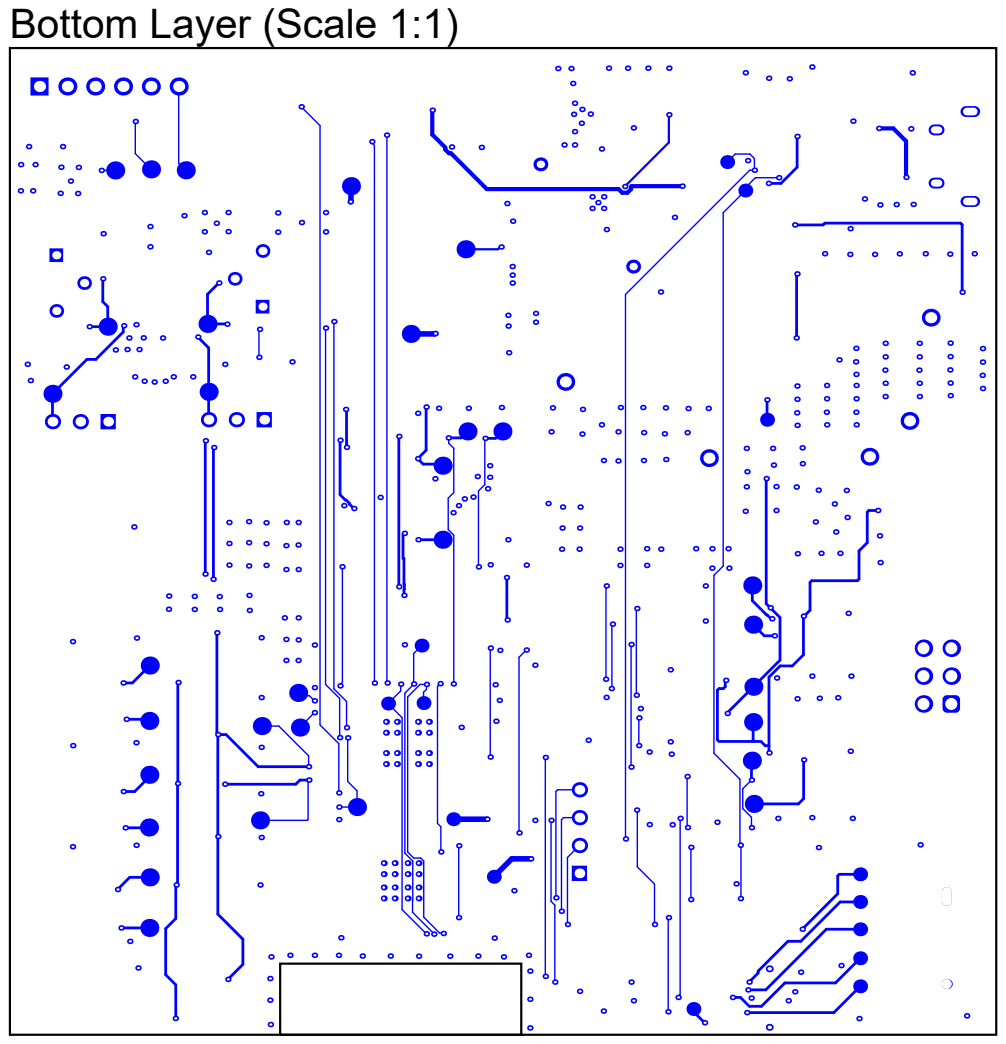
[picture p105: page 9]

Bottom Layer (Scale 1:1)

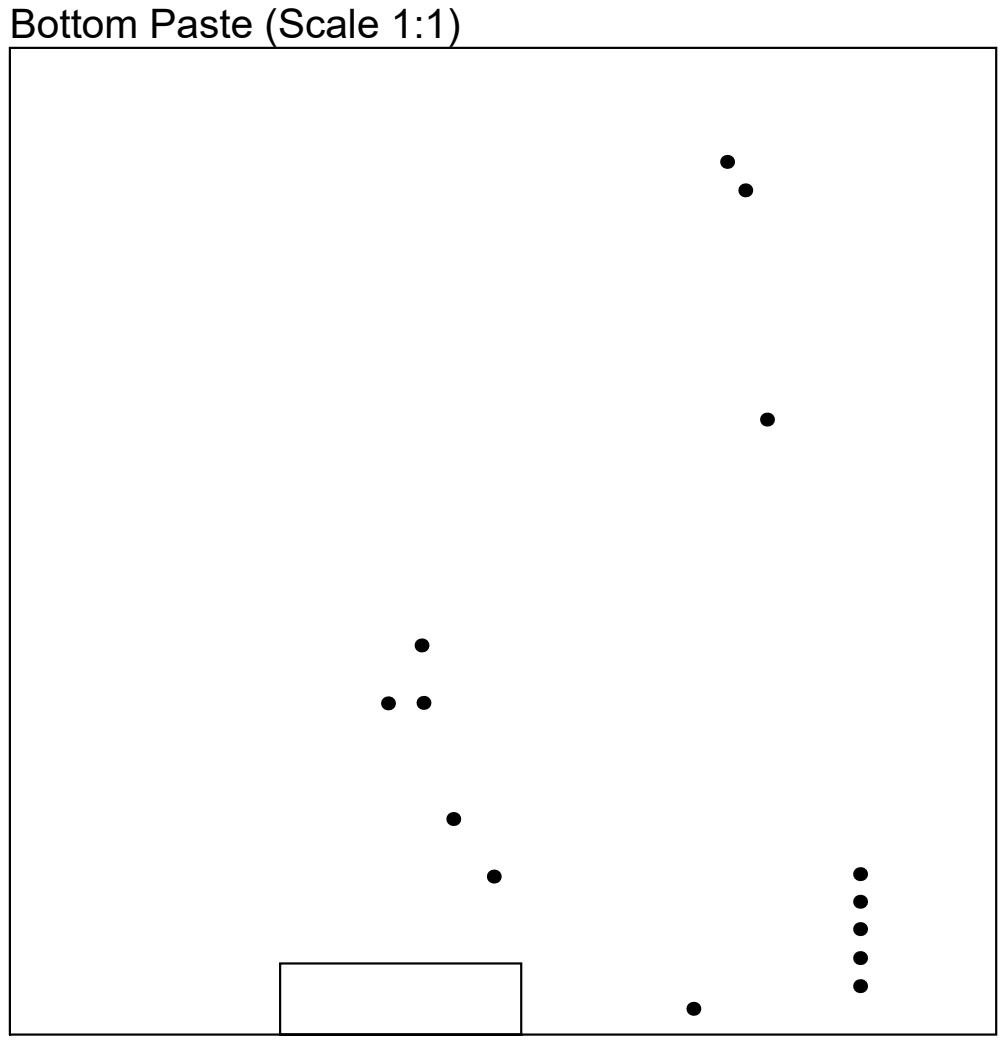
[picture p106: page 10]

Bottom Paste (Scale 1:1)

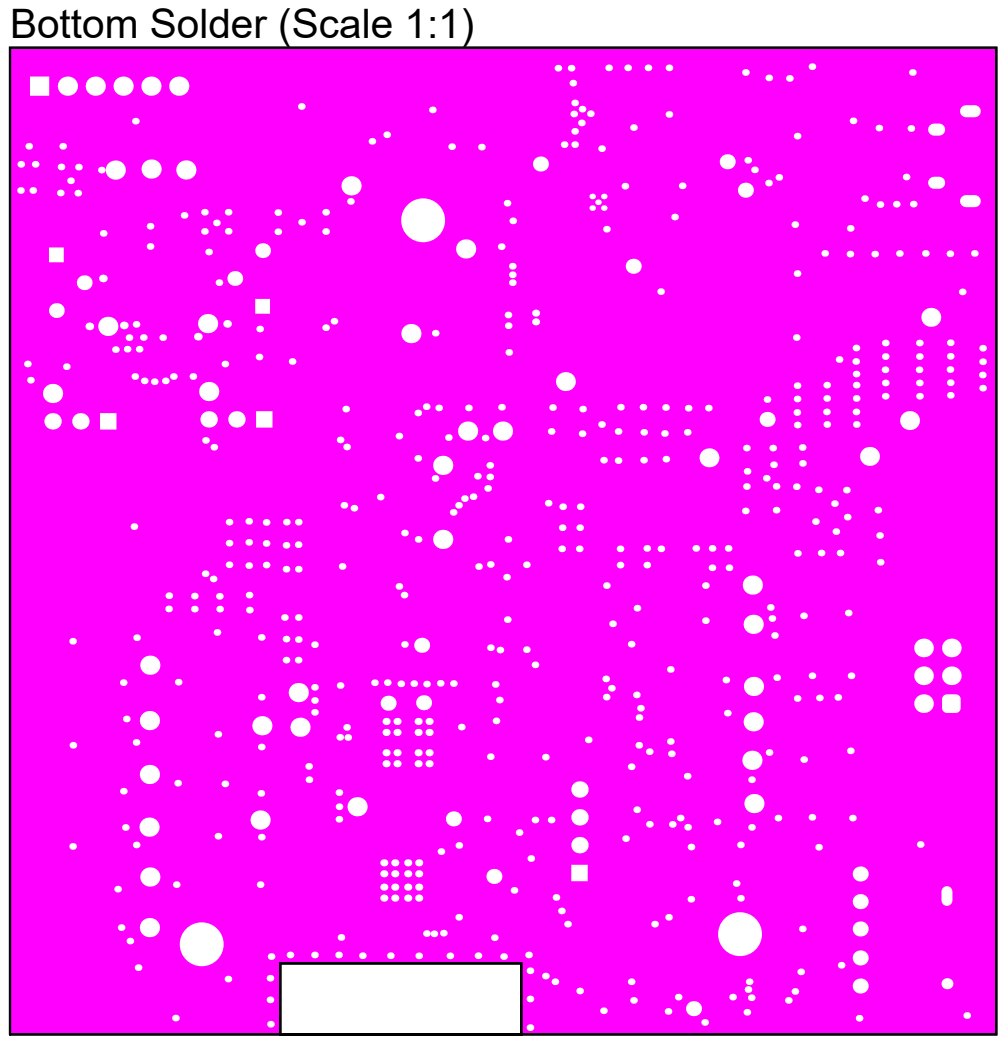
[picture p107: page 11]

Bottom Solder (Scale 1:1)

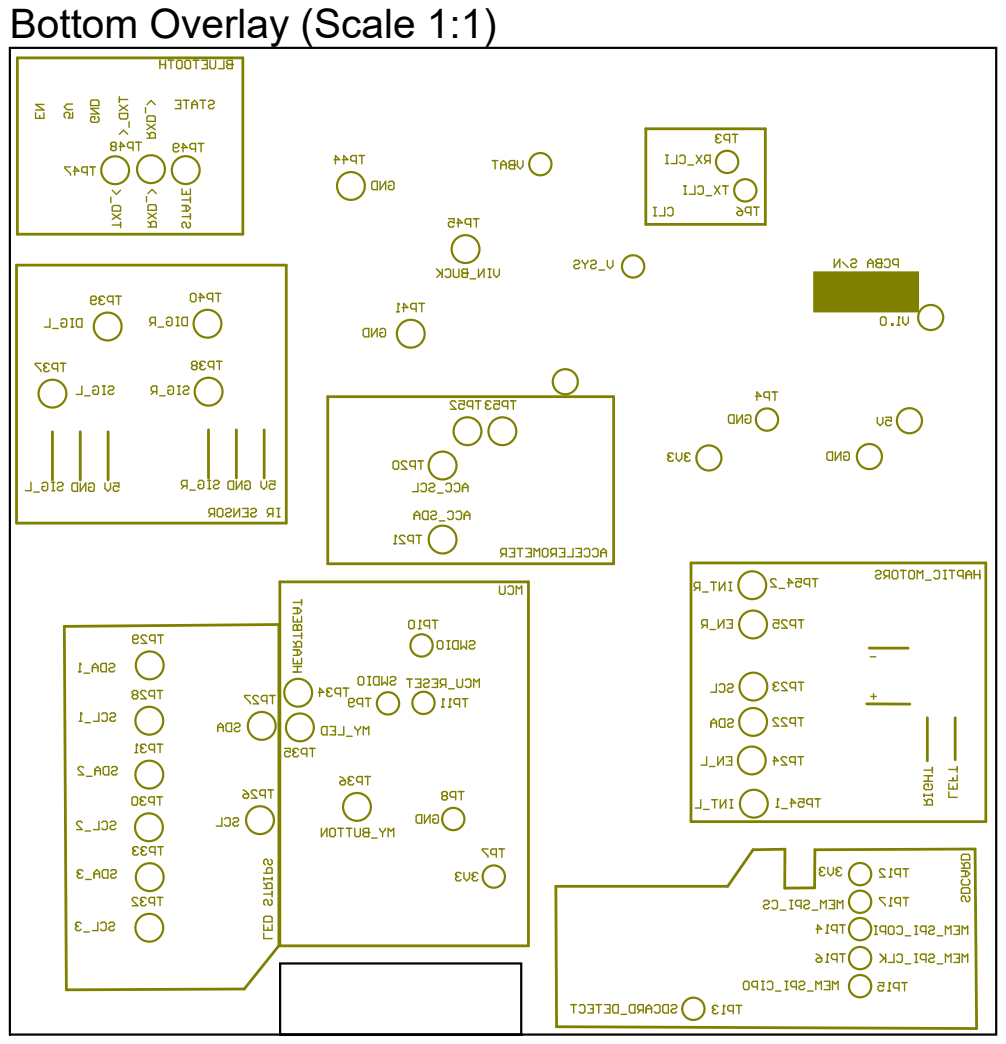
[picture p108: page 12]

Bottom Overlay (Scale 1:1)

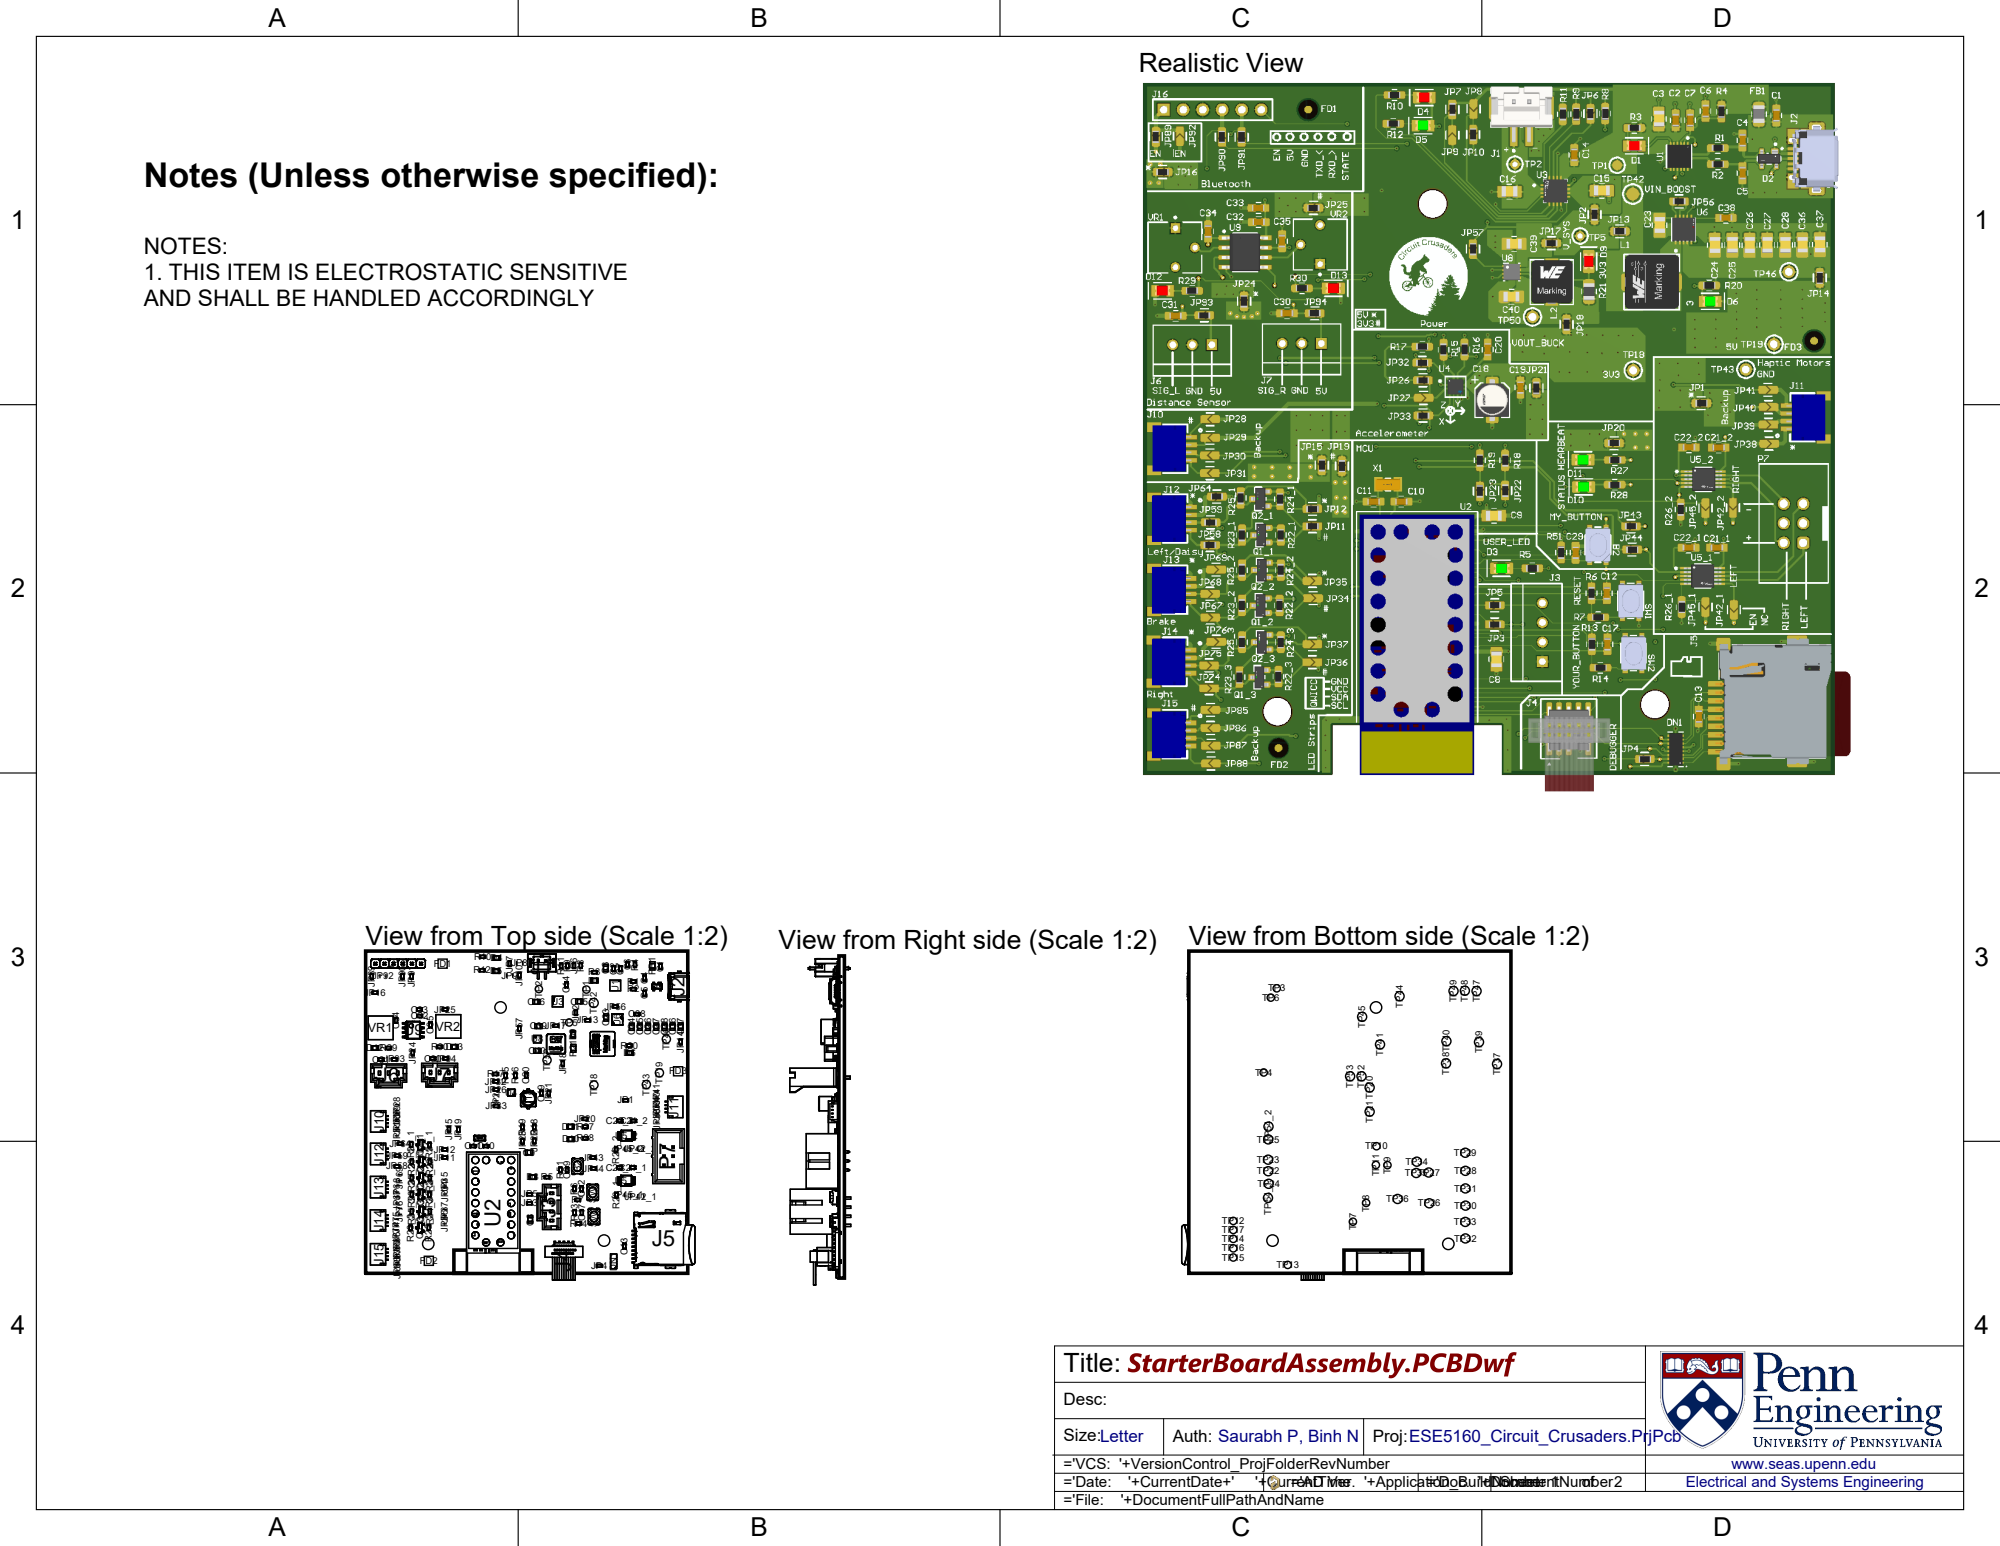
[picture p109: page 13]

Notes (Unless otherwise specified):

NOTES:
1. THIS ITEM IS ELECTROSTATIC SENSITIVE
AND SHALL BE HANDLED ACCORDINGLY

View from Bottom side (Scale 1:2)

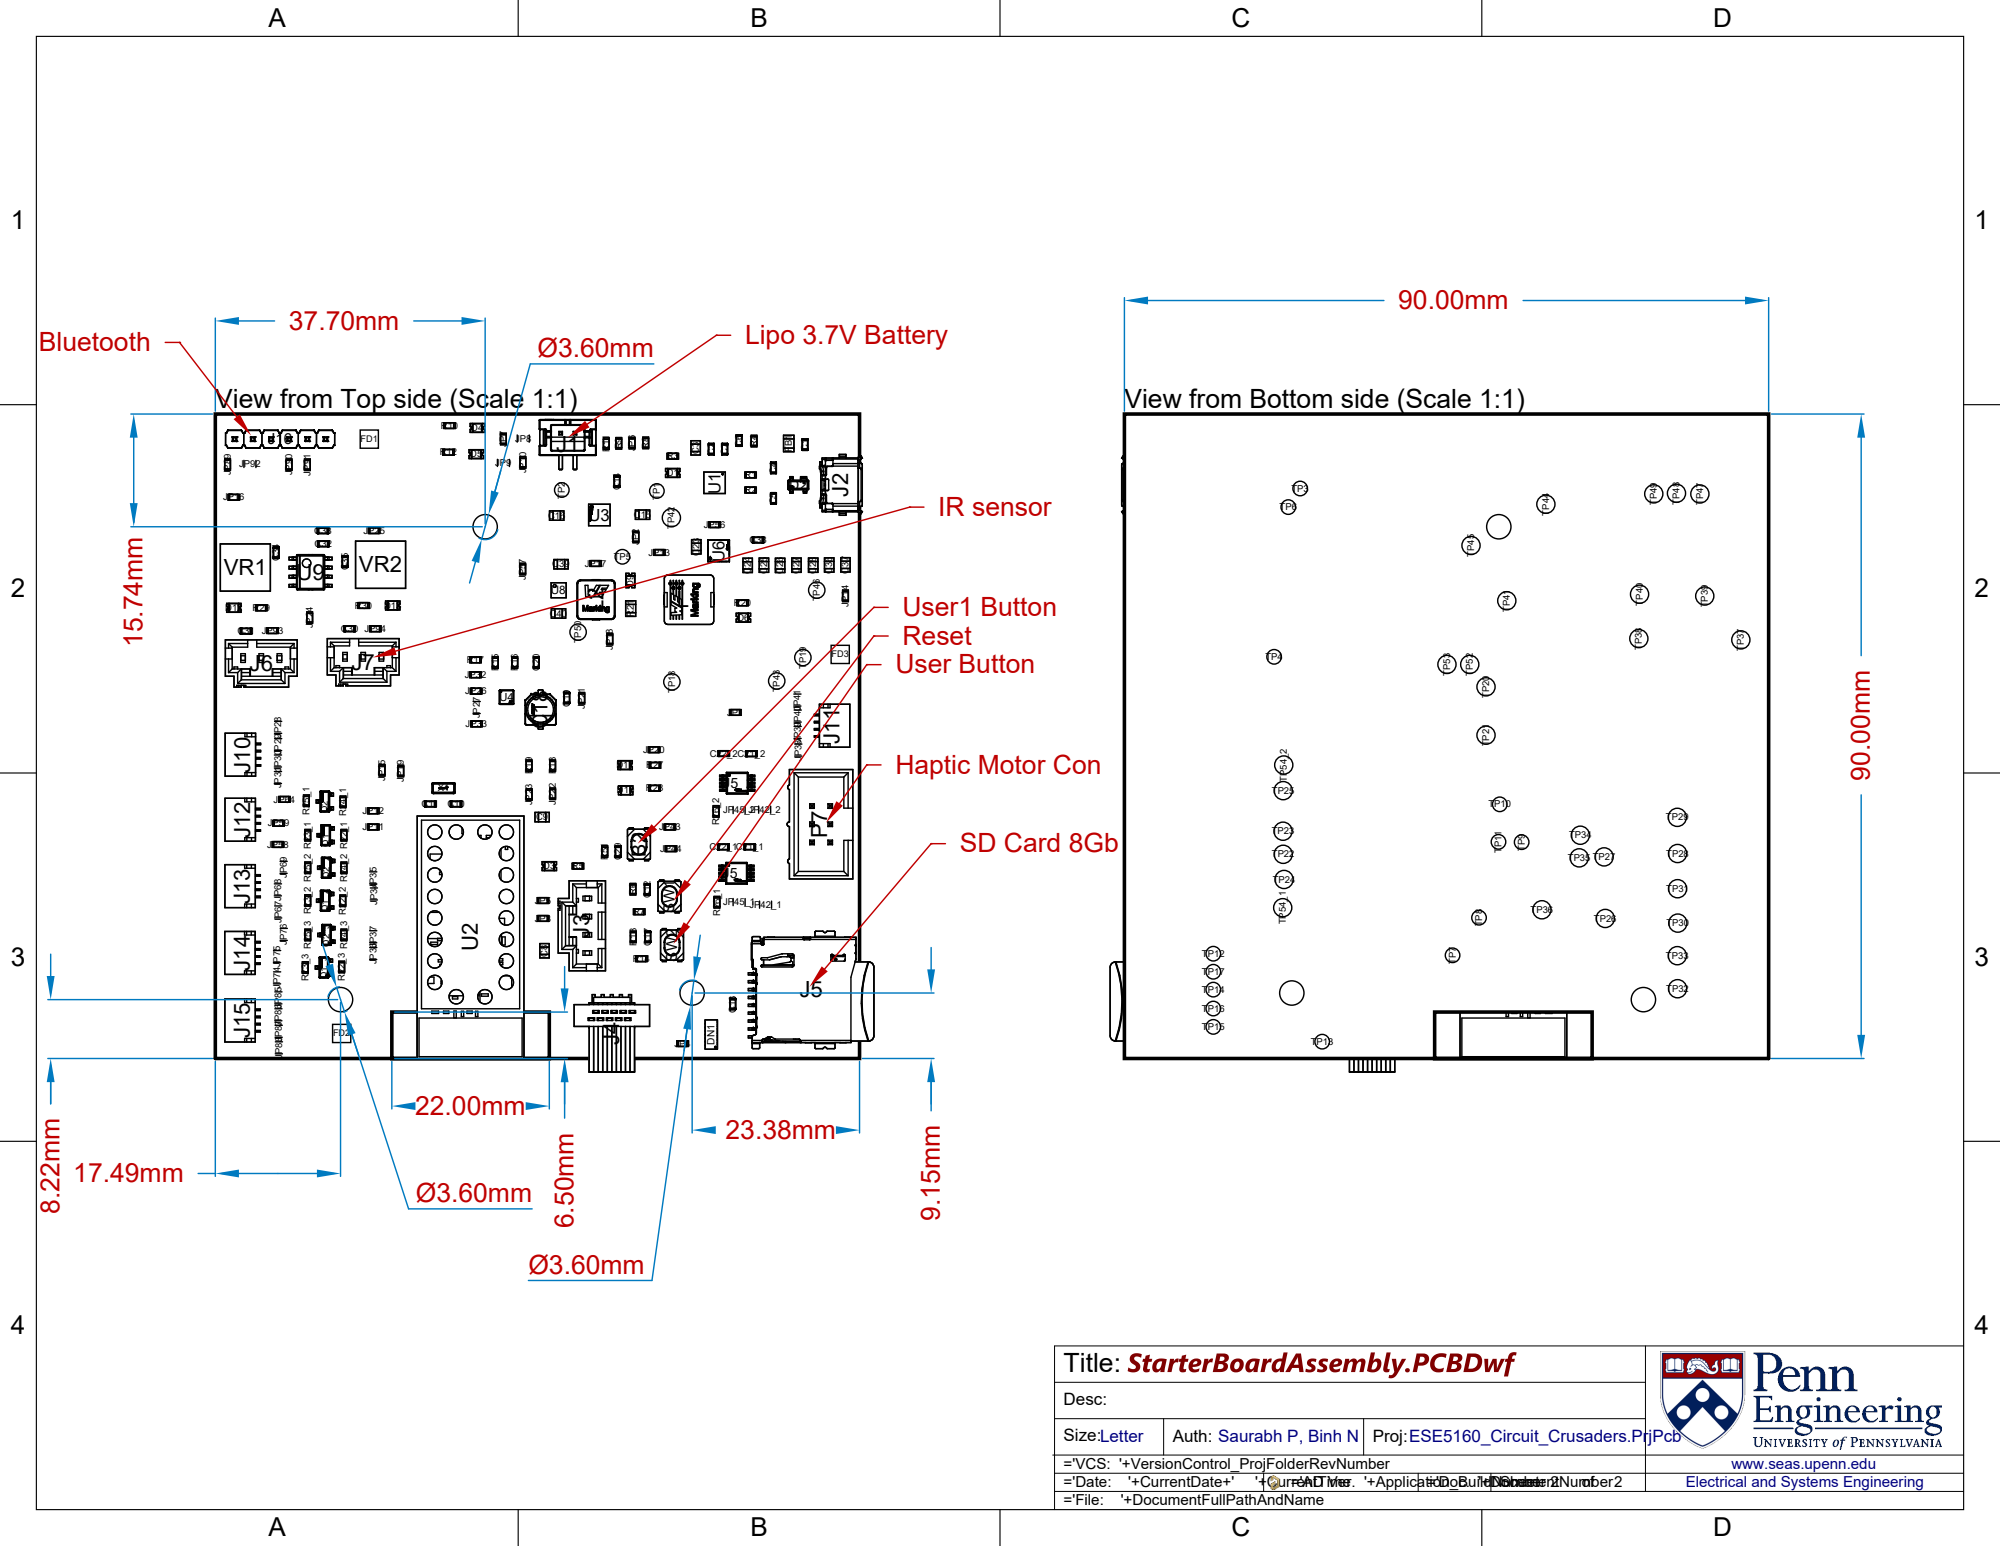
[picture p110: page 14]

View from Top side (Scale 1:1)

View from Bottom side (Scale 1:1)
