saurabhparulekar24/HelMate/A07G_exploring-the-cli/Application/src/secret.h

#ifndef SECRET_H_INCLUDED
#define SECRET_H_INCLUDED

#define SELECT_AUTH 1

#if(SELECT_AUTH==1)
#define SSID "Three Musketeers"
#define PWD "dunkinkamkhao"
#elif(SELECT_AUTH==2)
#define SSID "VincentSSID"
#define PWD "VincentPWD"
#endif



#endif /* SECRET_H_INCLUDED */
