saurabhparulekar24/HelMate/(commit log)

2024-05-15 Push upto A06P
    [A01G bom - Circuit Crusders.xlsx, A03G non pcba bom - Circuit Crusaders.xlsx, BOM_[No Variations].csv]
2024-05-18 Pushing name change upto 7
    [A01G bom - Circuit Crusders.xlsx, A03G non pcba bom - Circuit Crusaders.xlsx, BOM_[No Variations].csv]
