saurabhparulekar24/HelMate/A08G_comm-protocols/Images and Captures/IMU_Setup.jpg

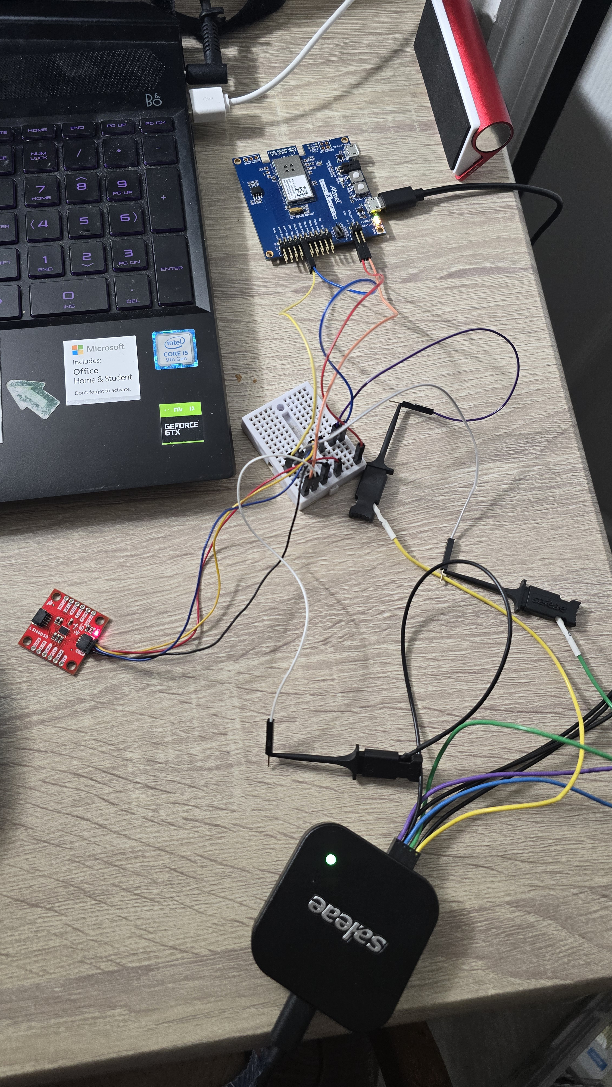
A08G_comm-protocols/Images and Captures/IMU_Setup.jpg
