saurabhparulekar24/HelMate/A11G_board-bringup/Images/Eload Setup.jpg

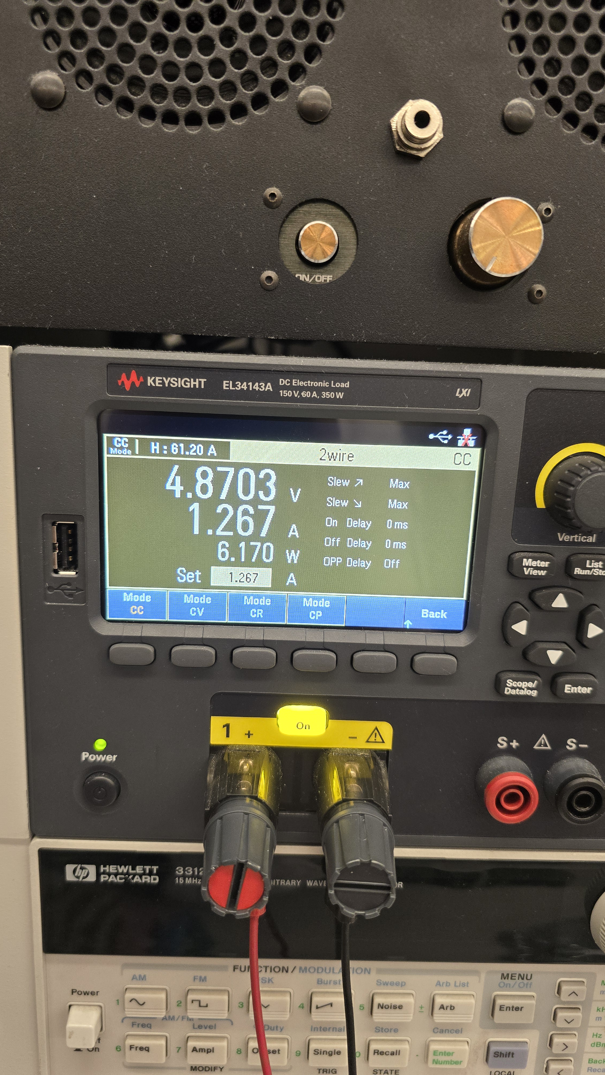
A11G_board-bringup/Images/Eload Setup.jpg
