saurabhparulekar24/HelMate/A11G_board-bringup/Images/Programmer_Board.jpg

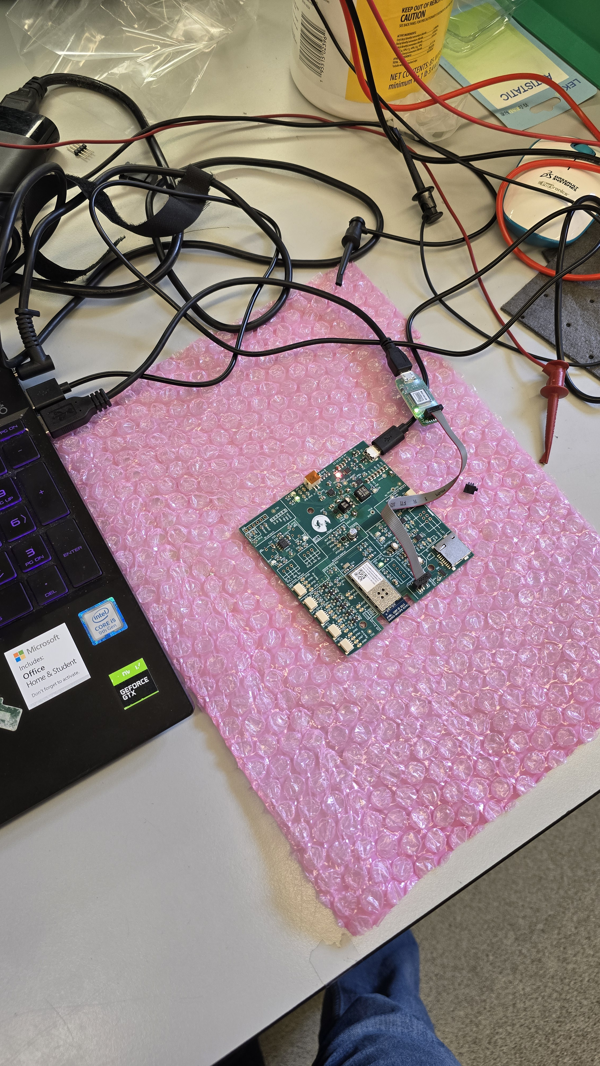
A11G_board-bringup/Images/Programmer_Board.jpg
